topnotcher/gforce/master/ee/chest-xmega-rgb.pdf

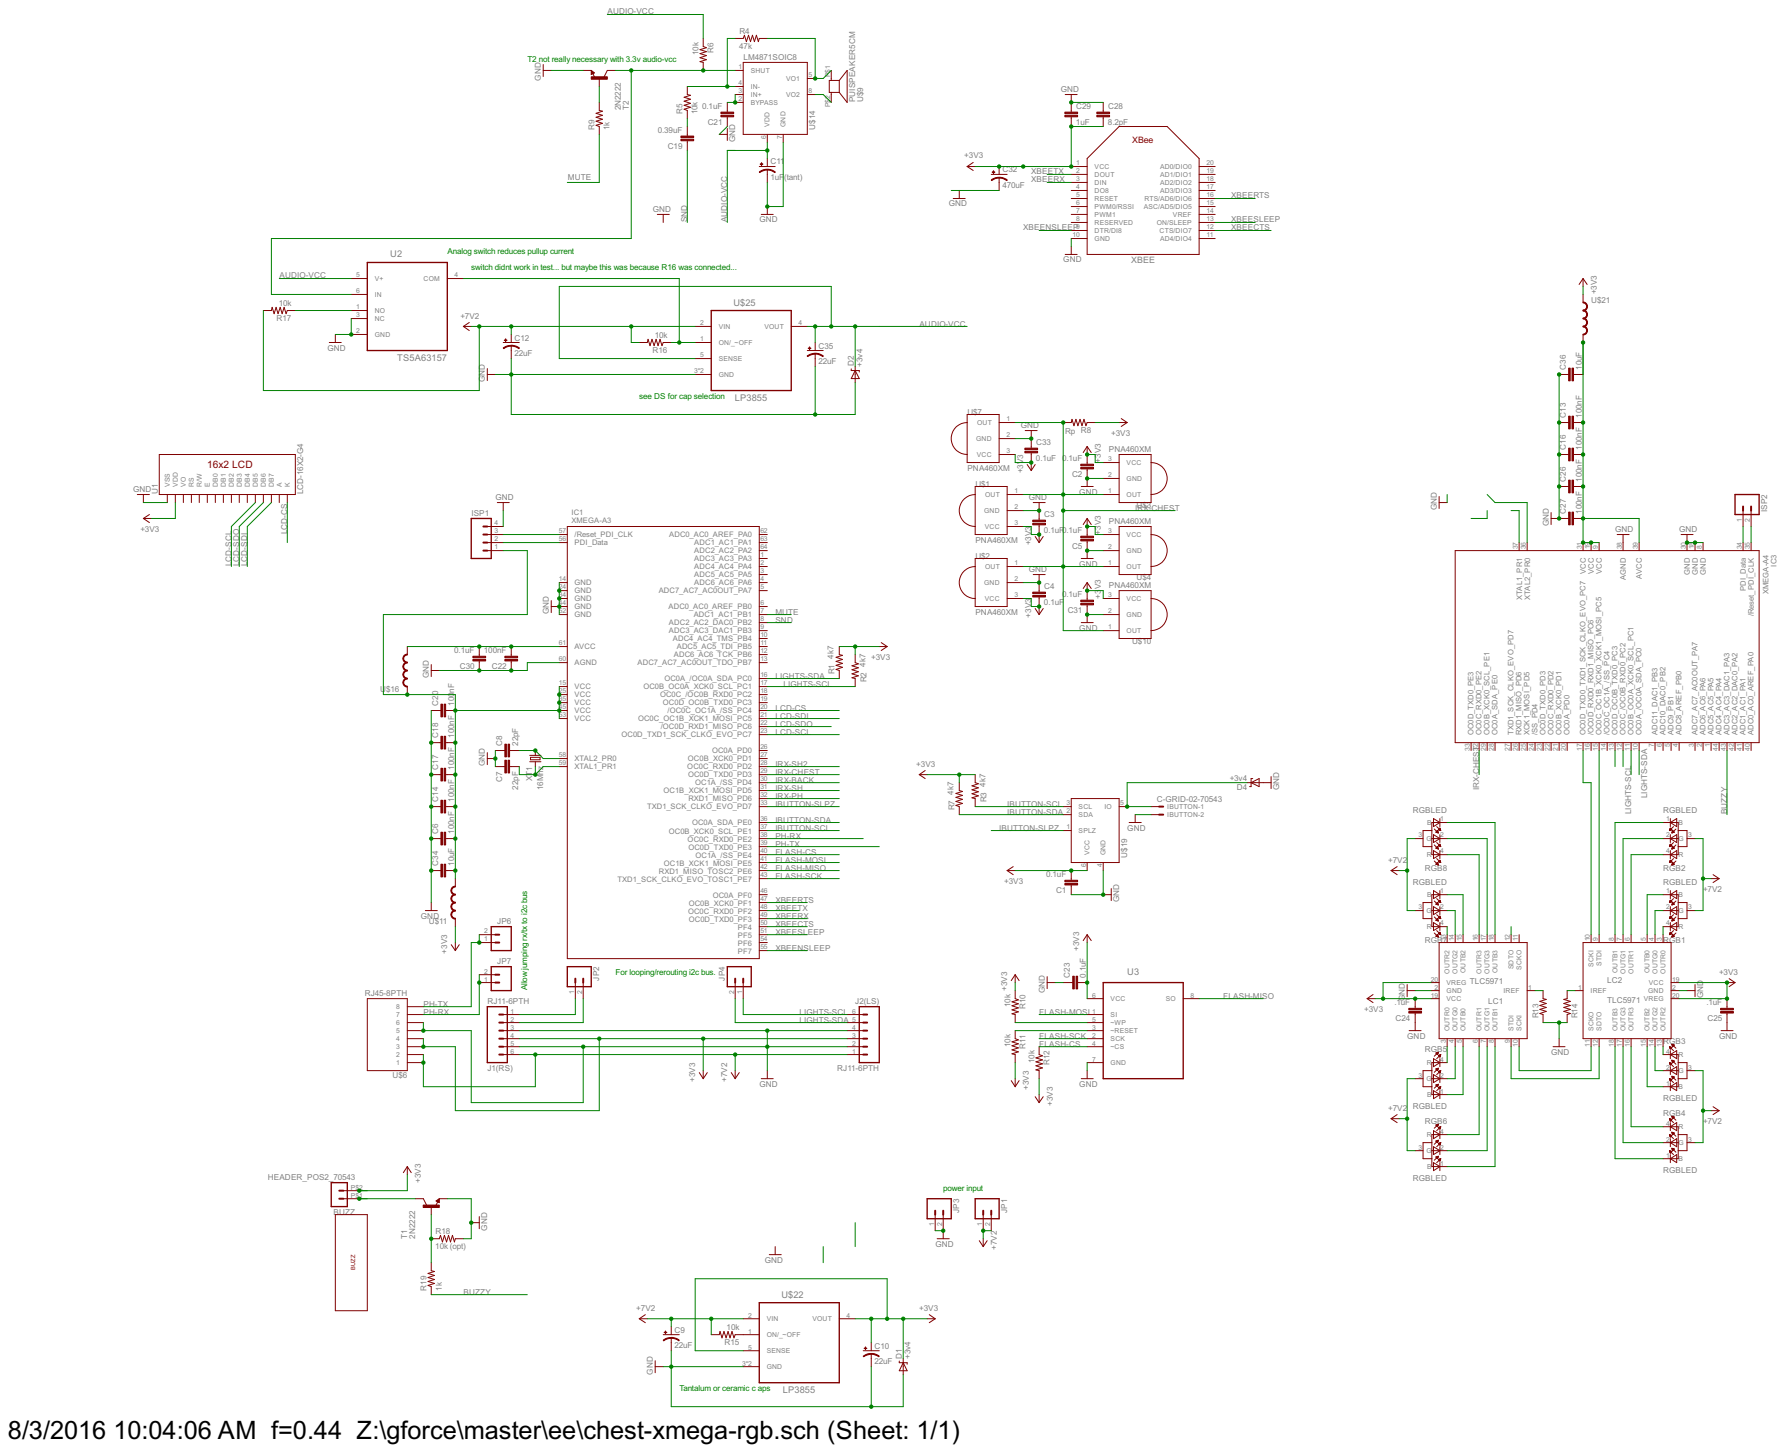
[picture p1: page 1]

T2 not really necessary with 3.3v audio-vcc

Analog switch reduces pullup current

switch didnt work in test... but maybe this was because R16 was connected...
+7V2 GND

see DS for cap selection

For looping/rerouting i2c bus. Allow jumping rx/tx to i2c bus

Tantalum or ceramic c aps

8/3/2016 10:04:06 AM f=0.44 Z:\gforce\master\ee\chest-xmega-rgb.sch (Sheet: 1/1)
