topnotcher/gforce/shoulder/ee/shoulder-board.pdf

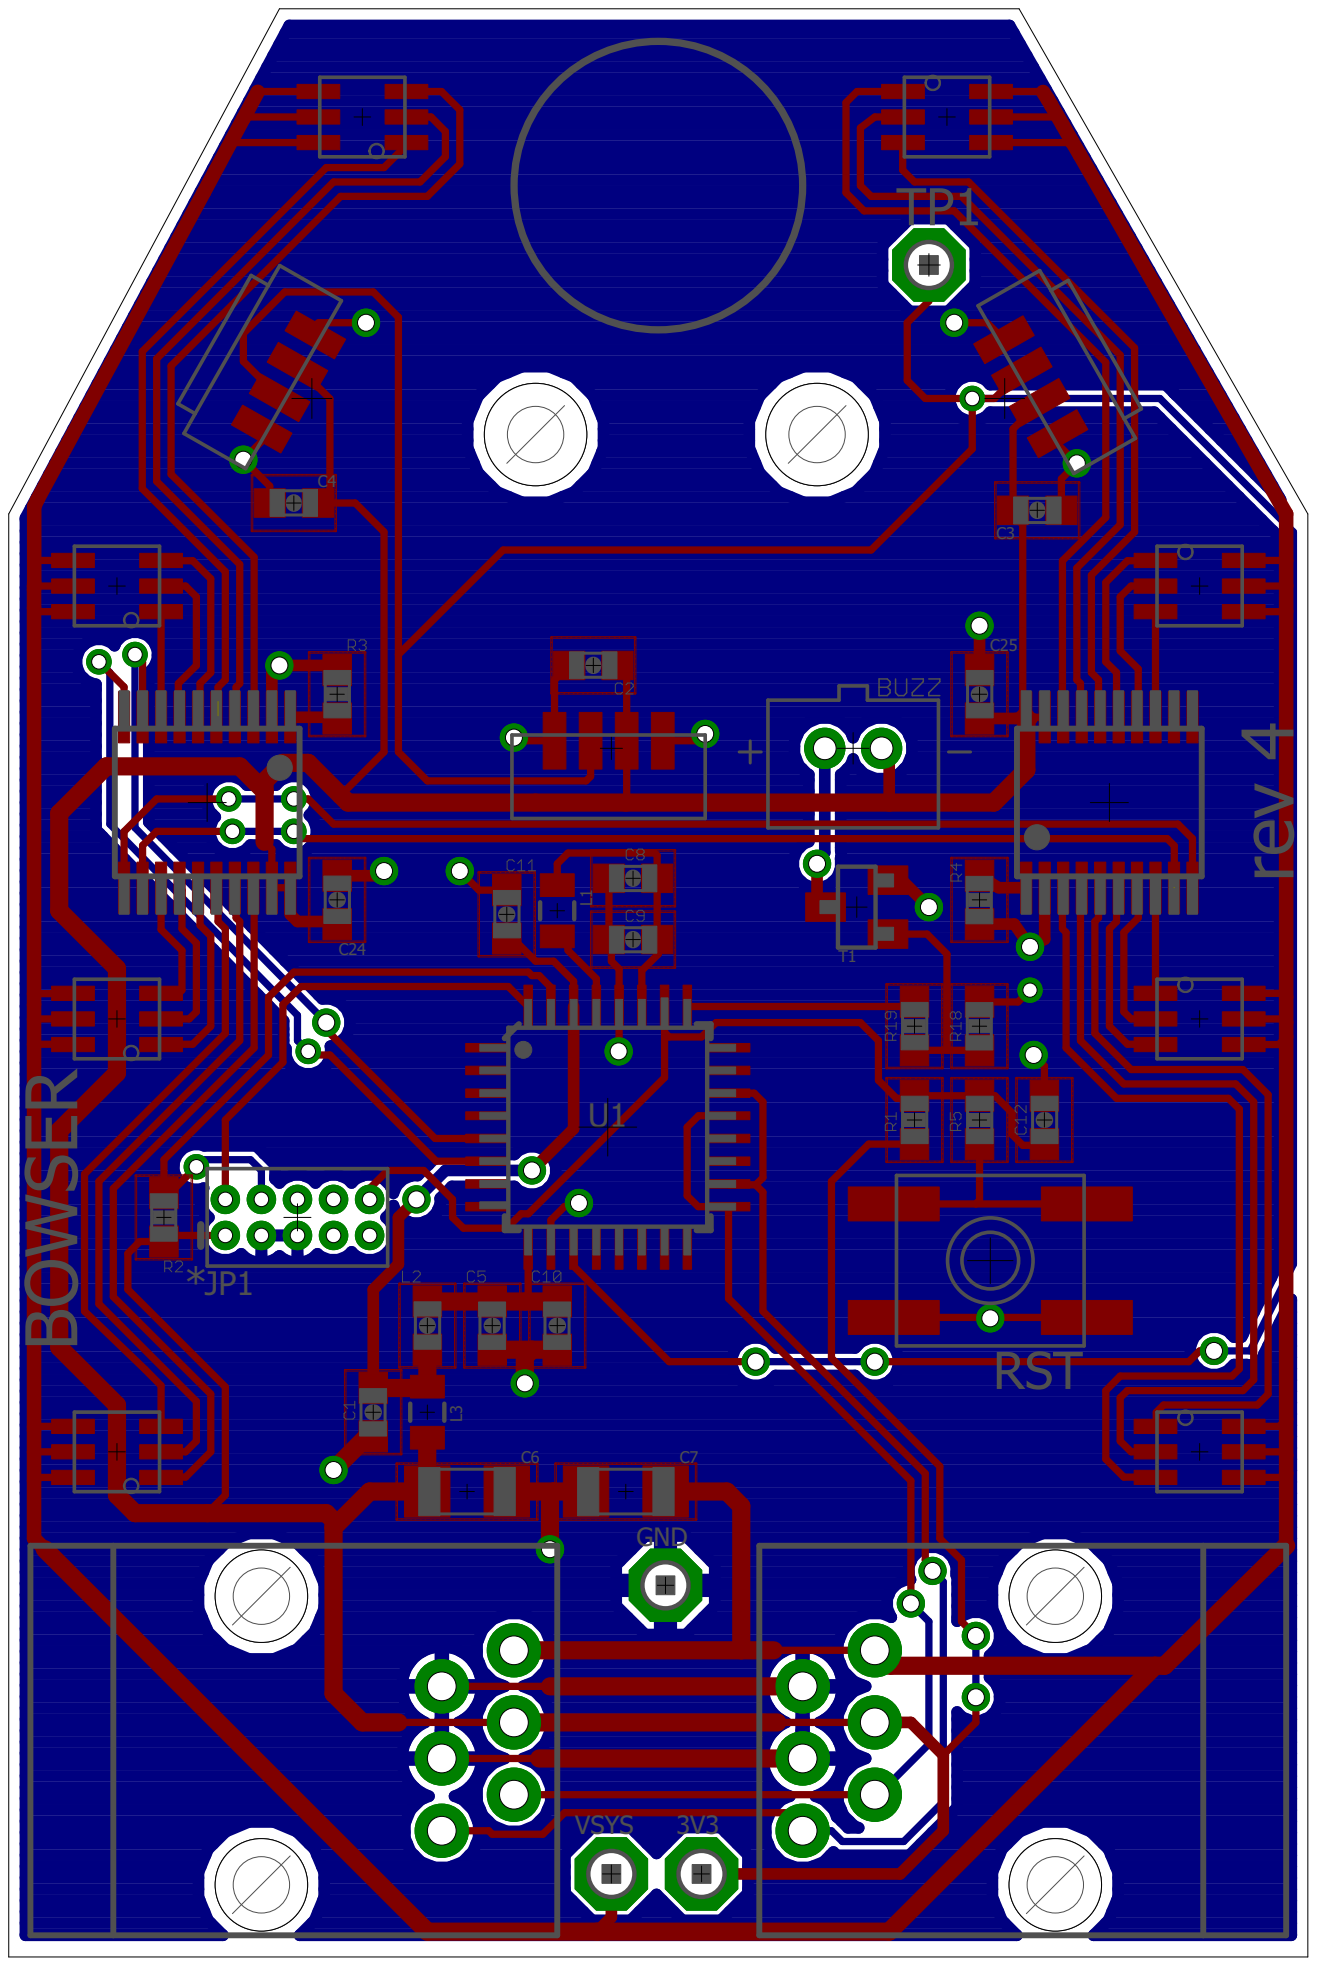
[picture p2: page 1]
