topnotcher/gforce/shoulder/ee/shoulder.pdf

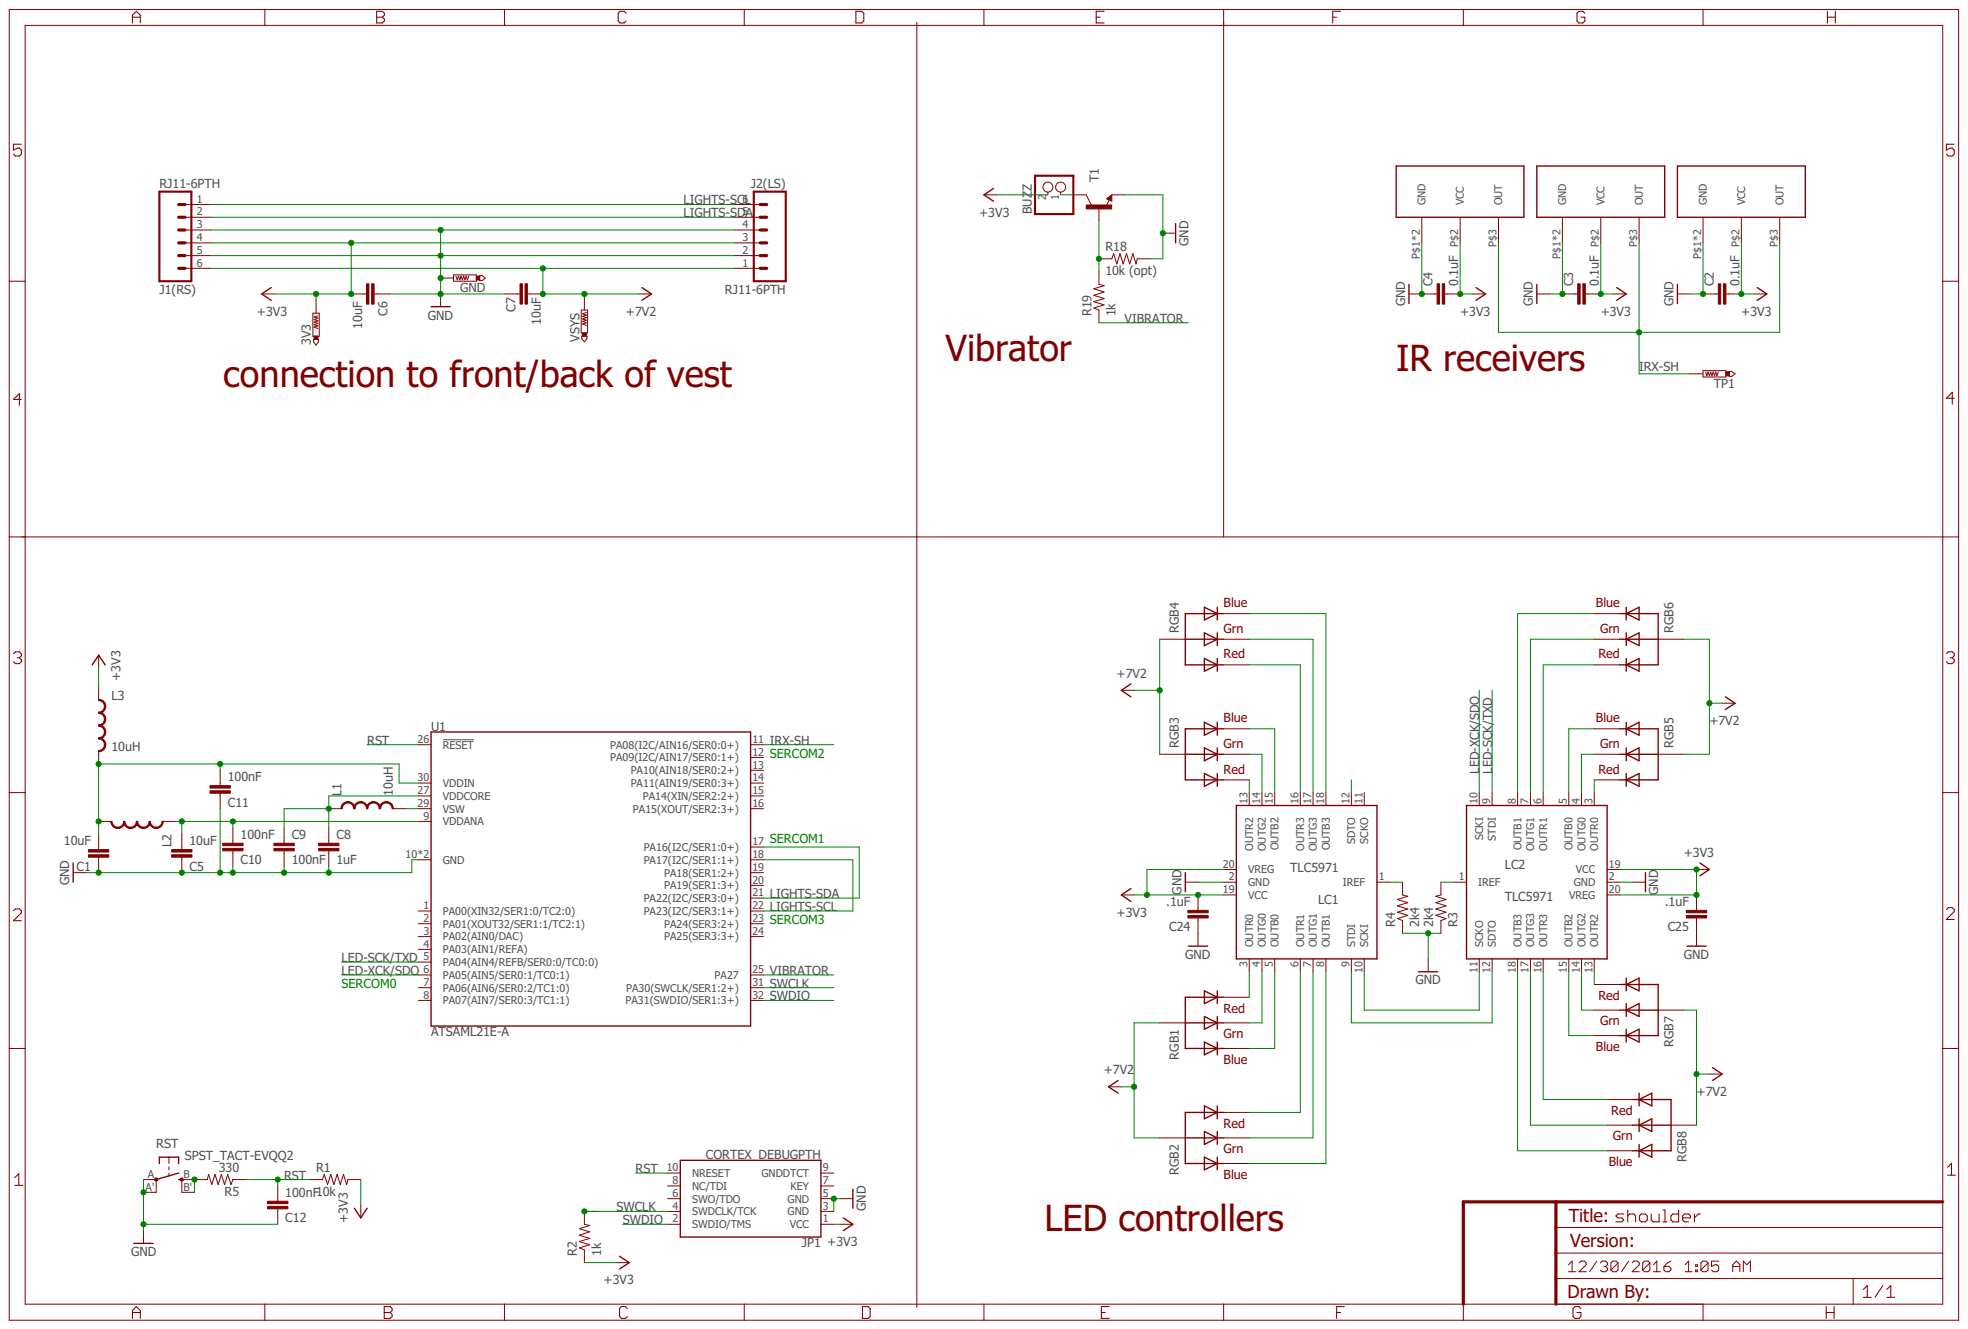
[picture p3: page 1]

Red Grn BlueRed Grn Blue
