topnotcher/gforce/phasor/ee/phasor-board.pdf

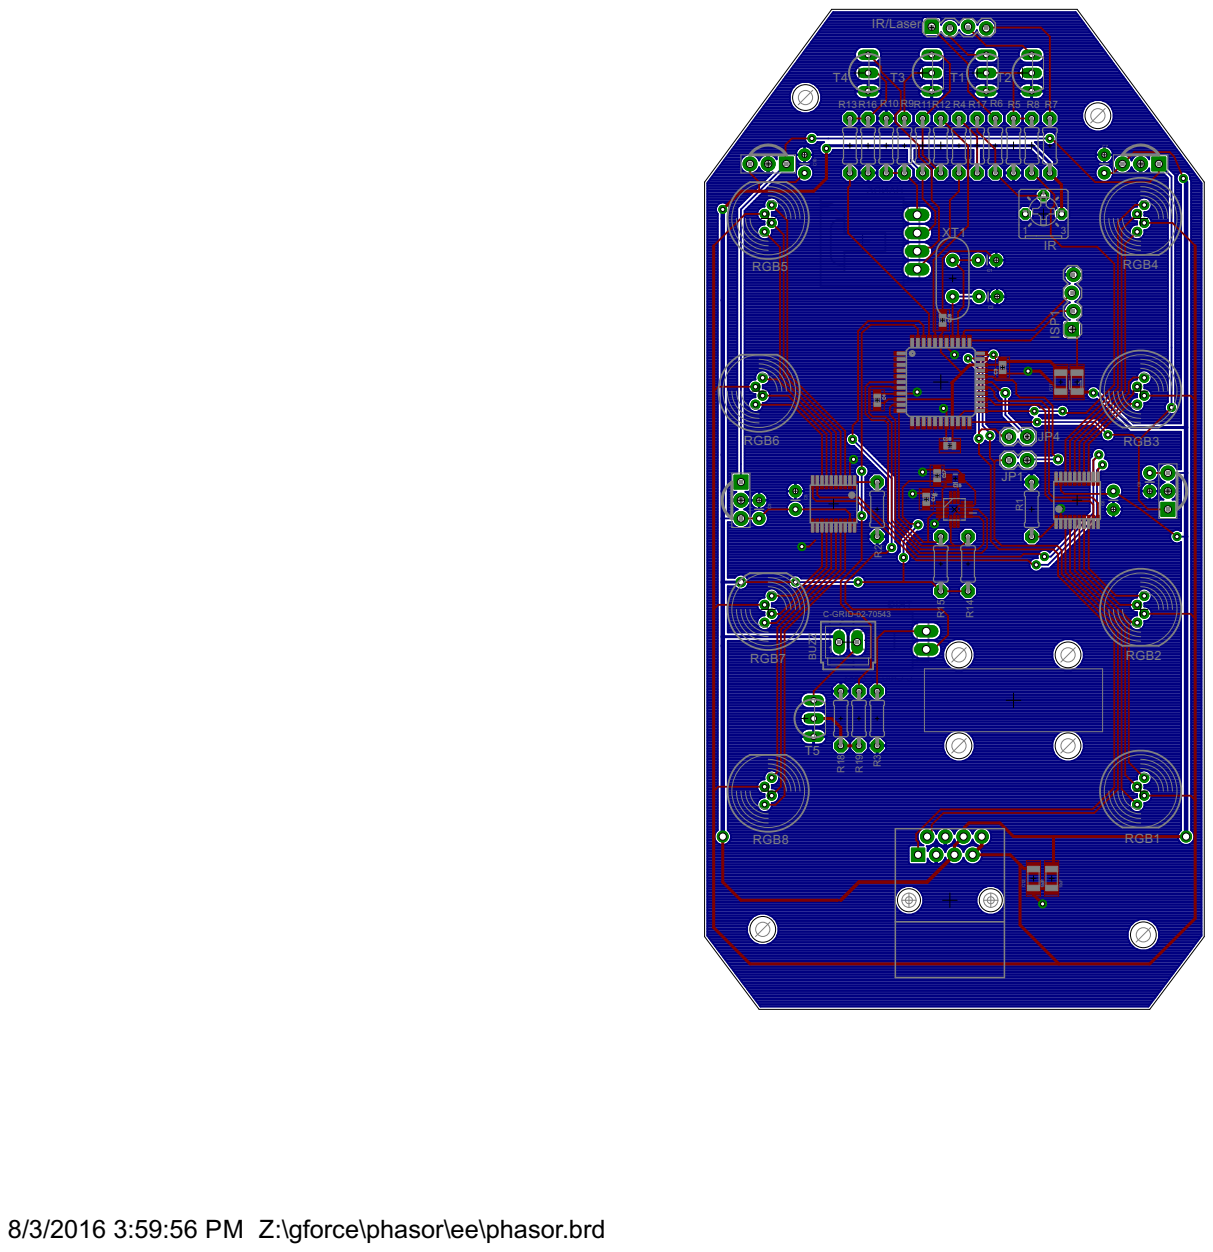
[picture p4: page 1]

8/3/2016 3:59:56 PM Z:\gforce\phasor\ee\phasor.brd
