topnotcher/gforce/phasor/ee/phasor.pdf

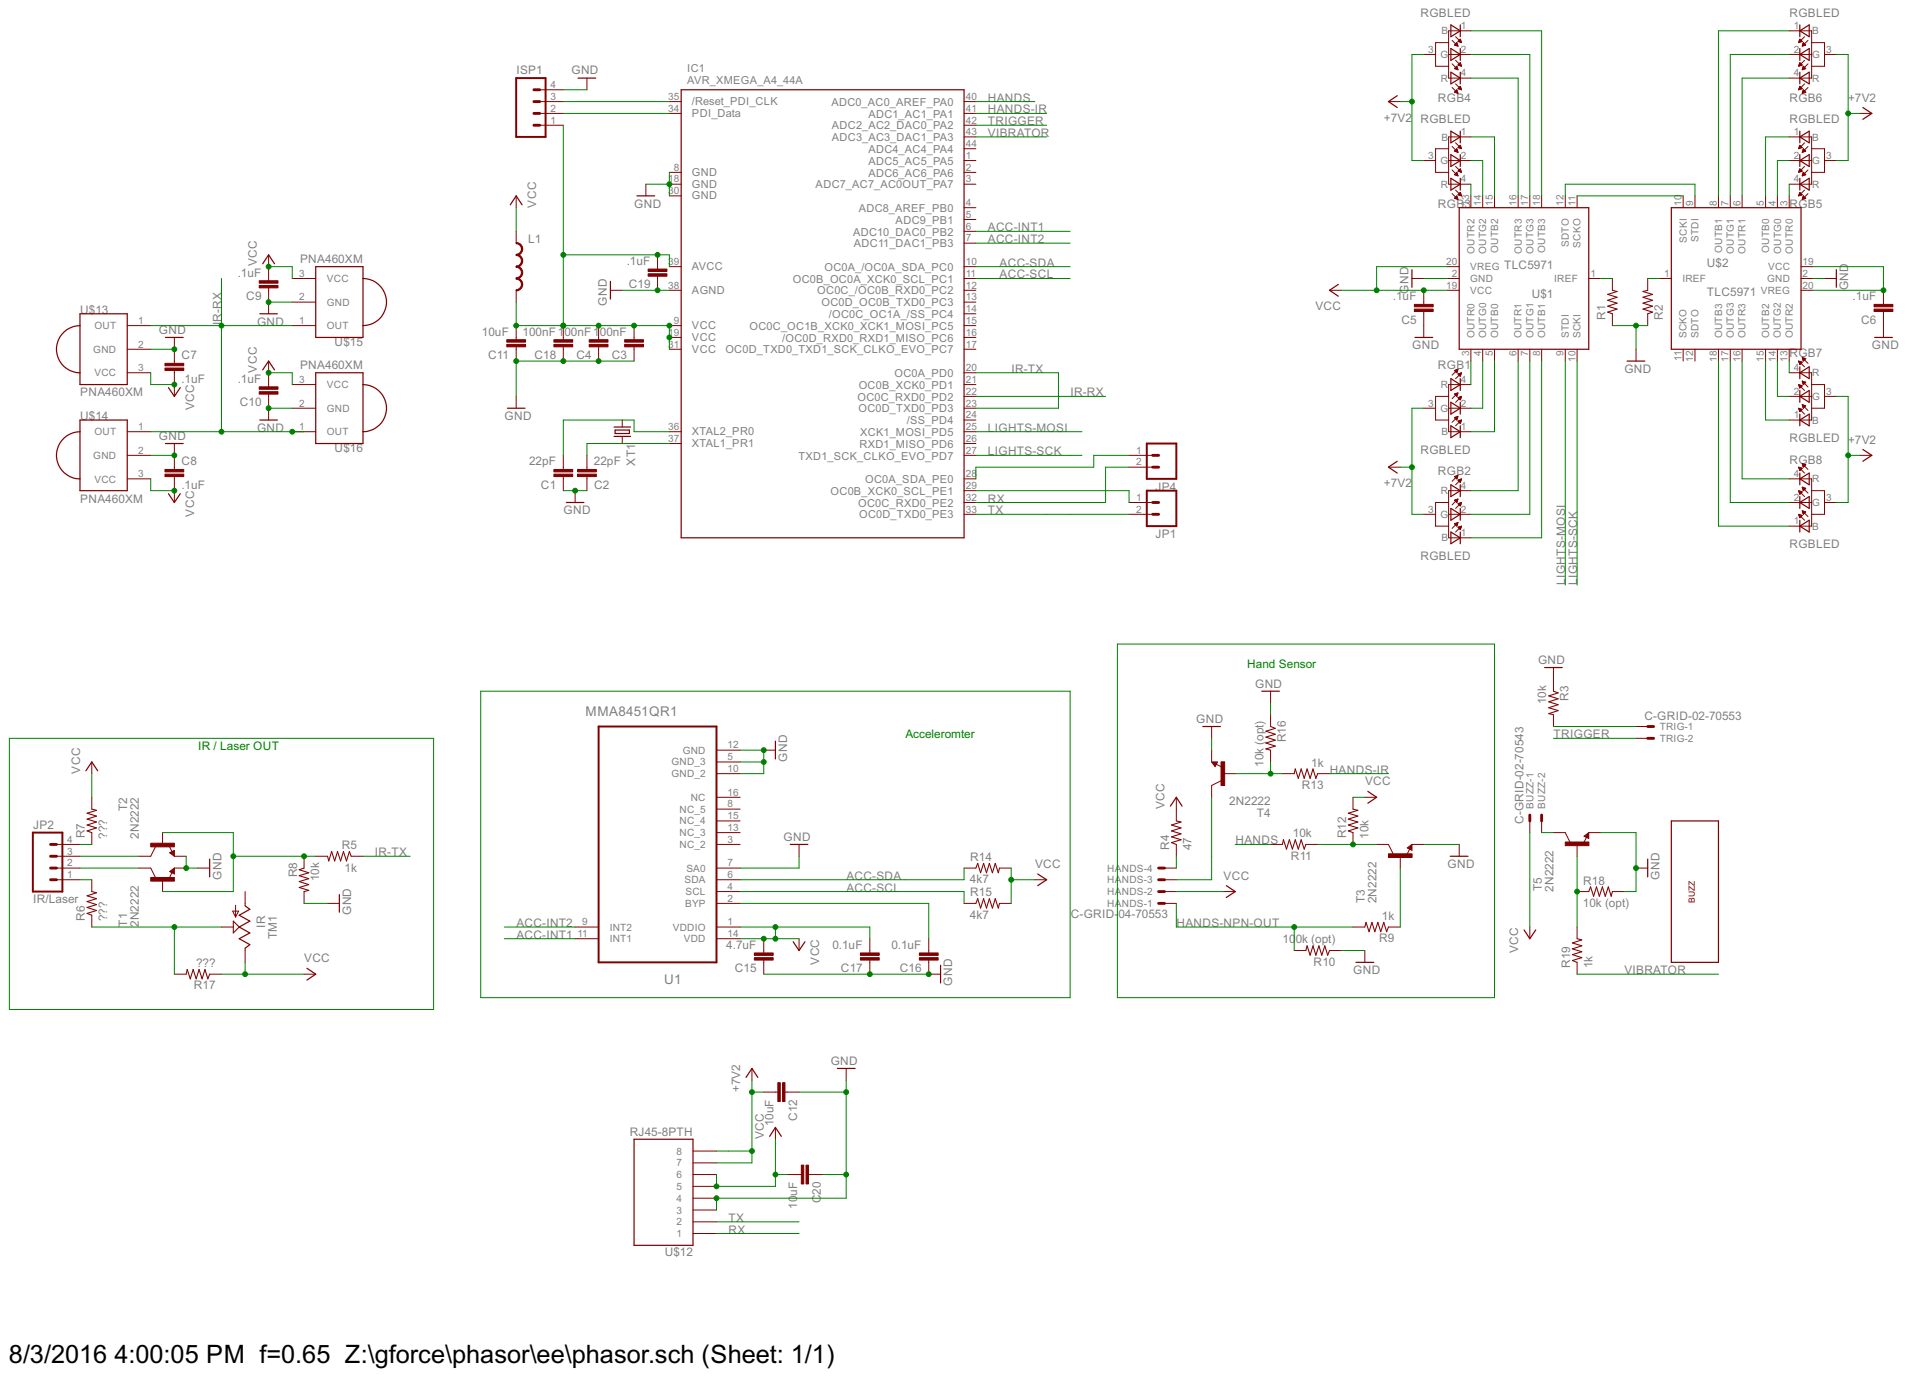
[picture p5: page 1]

HANDS-1 HANDS-2 HANDS-3 HANDS-4

HANDS-NPN-OUT ACC-INT1

8/3/2016 4:00:05 PM f=0.65 Z:\gforce\phasor\ee\phasor.sch (Sheet: 1/1)
