topnotcher/gforce/master/ee/chest-xmega-rgb-board.pdf

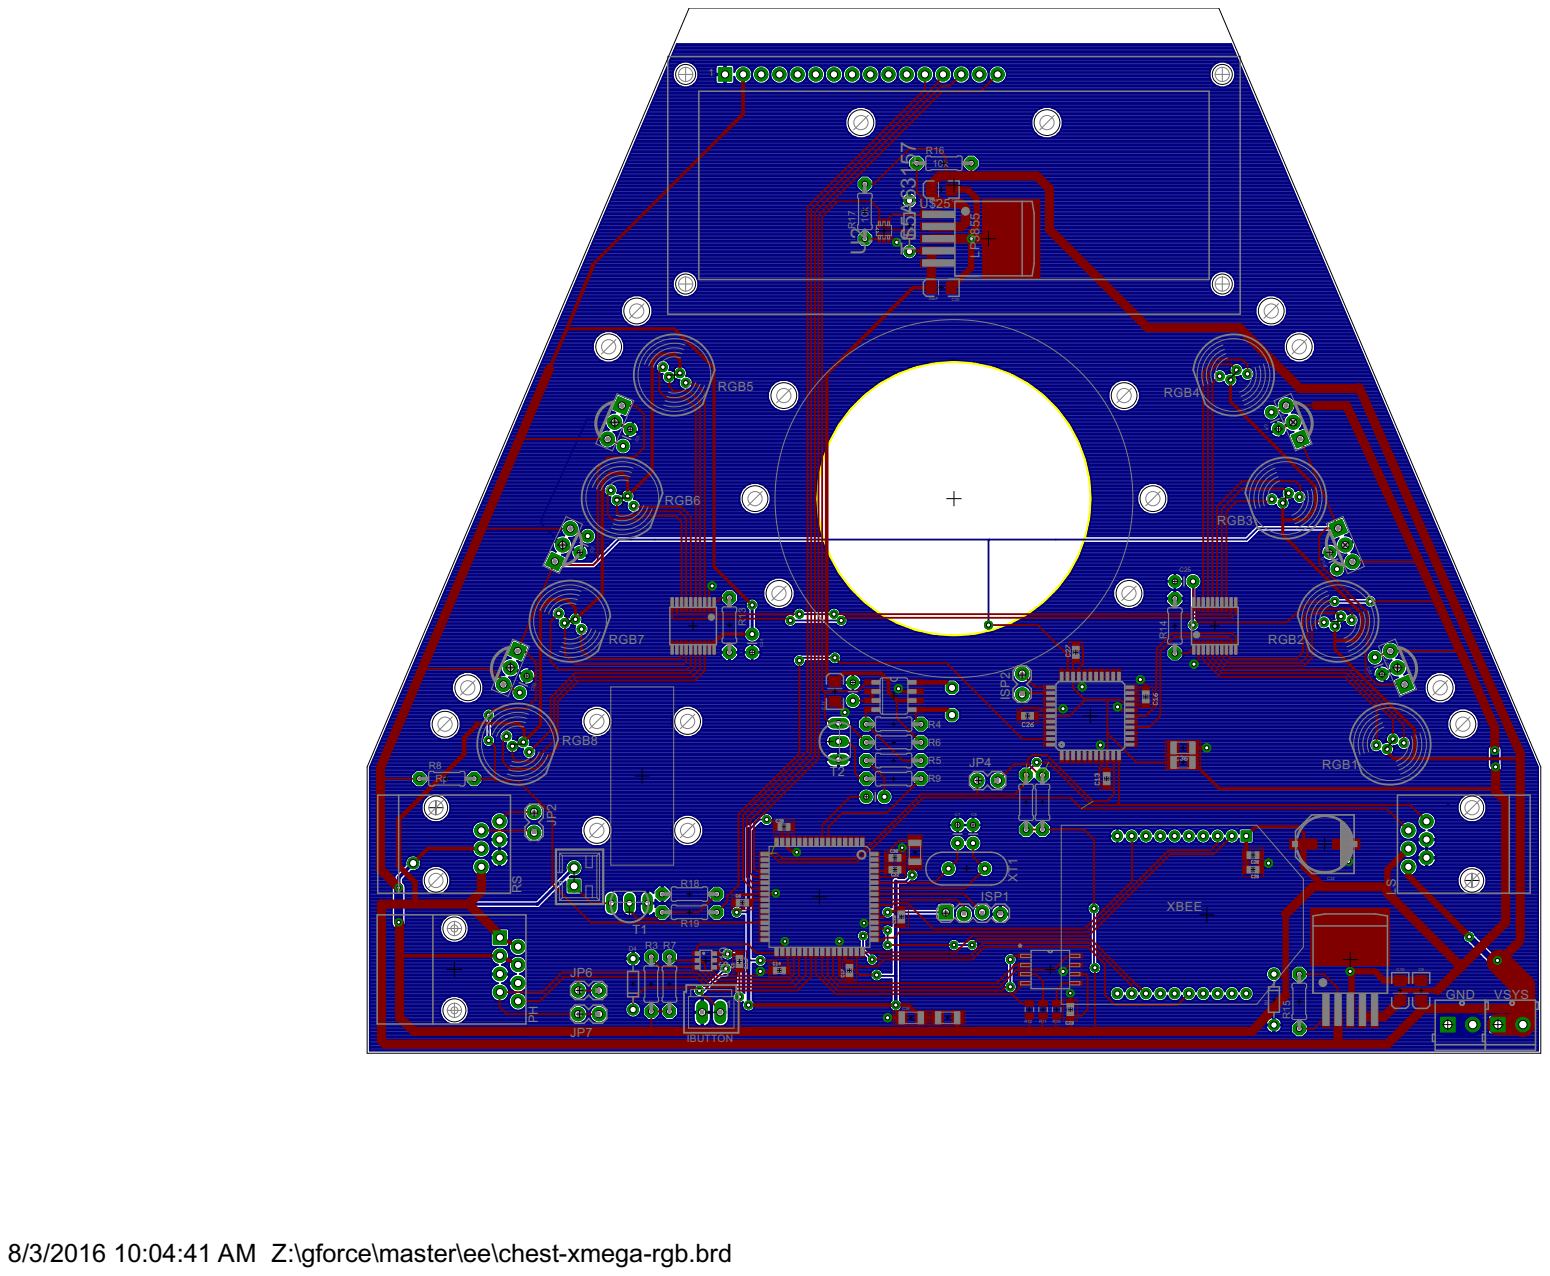
[picture p6: page 1]

8/3/2016 10:04:41 AM Z:\gforce\master\ee\chest-xmega-rgb.brd
