topnotcher/gforce/charger/ee/batt-charger.brd

## EAGLE design charger/ee/batt-charger.brd (2017-11-22)

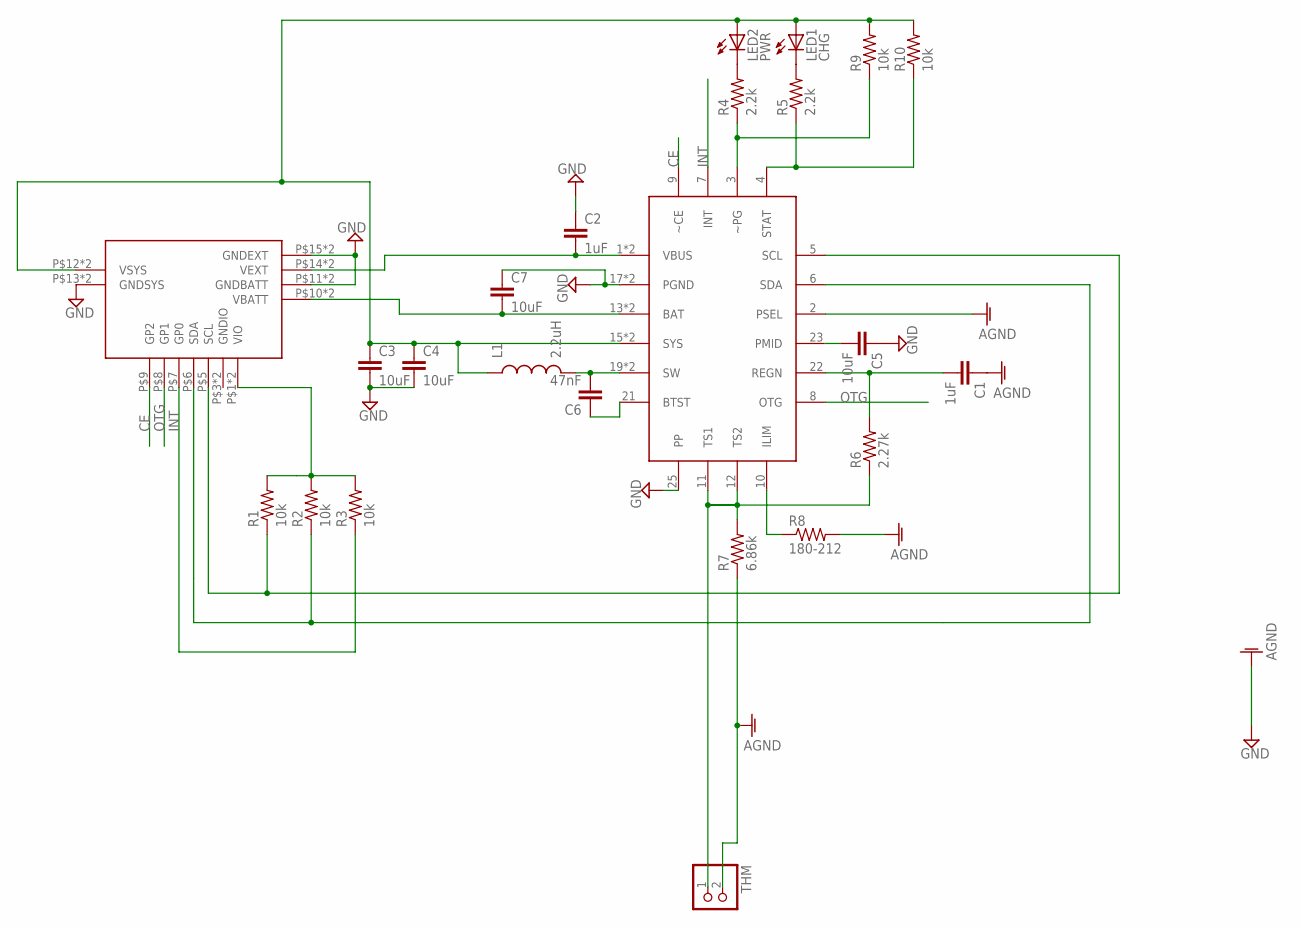
[picture p7: schematic batt-charger.sch]

Parts:
C1, C2: 1uF; 0603-CAP
C3, C4, C5, C7: 10uF; 1206
C6: 47nF; 0603-CAP
L1: 2.2uH; INDUCTOR-2020
LED1: CHG; CHIP-LED0603
LED2: PWR; CHIP-LED0603
R1, R2, R3, R9, R10: 10k; R0603
R4, R5: 2.2k; R0603
R6: 2.27k; R0603
R7: 6.86k; R0603
R8: 180-212; R0603
THM: JST_2PIN-THM; JST-PH-2-THM
U$1: BQ24193; QFN-400X400X100-25P
U$2: G4-CHG-SOCKETSTD; G4-CHG-SOCKET

Connections:
AGND: C1.1, R7.1, R8.2, THM.2 (1), U$1.2 (PSEL)
CE: U$1.9 (~CE), U$2.P$9 (GP2)
GND: C2.1, C3.2, C4.2, C5.1, C7.1, U$1.17 (PGND), U$1.18 (PGND), U$1.25 (PP), U$2.P$11 (GNDBATT), U$2.P$13 (GNDSYS), U$2.P$15 (GNDEXT), U$2.P$17 (GNDBATT), U$2.P$19 (GNDSYS), U$2.P$21 (GNDEXT)
INT: R3.1, U$1.7 (INT), U$2.P$7 (GP0)
unnamed: C6.2, L1.P$2 (2), U$1.19 (SW), U$1.20 (SW)
unnamed: R1.1, U$1.5 (SCL), U$2.P$5 (SCL)
unnamed: R2.1, U$1.6 (SDA), U$2.P$6 (SDA)
unnamed: C6.1, U$1.21 (BTST)
unnamed: LED2.C, R4.2
unnamed: LED1.C, R5.2
unnamed: R4.1, R9.1, U$1.3 (~PG)
unnamed: R5.1, R10.1, U$1.4 (STAT)
unnamed: C1.2, R6.2, U$1.22 (REGN)
unnamed: R6.1, R7.2, THM.1 (2), U$1.11 (TS1), U$1.12 (TS2)
unnamed: R8.1, U$1.10 (ILIM)
unnamed: C5.2, U$1.23 (PMID)
OTG: U$1.8 (OTG), U$2.P$8 (GP1)
VBATT: C7.2, U$1.13 (BAT), U$1.14 (BAT), U$2.P$10 (VBATT), U$2.P$16 (VBATT)
VEXT: C2.2, U$1.1 (VBUS), U$1.24 (VBUS), U$2.P$14 (VEXT), U$2.P$20 (VEXT)
VIO: R1.2, R2.2, R3.2, U$2.P$1 (VIO), U$2.P$2 (VIO)
VSYS: C3.1, C4.1, L1.P$1 (1), LED1.A, LED2.A, R9.2, R10.2, U$1.15 (SYS), U$1.16 (SYS), U$2.P$12 (VSYS), U$2.P$18 (VSYS)

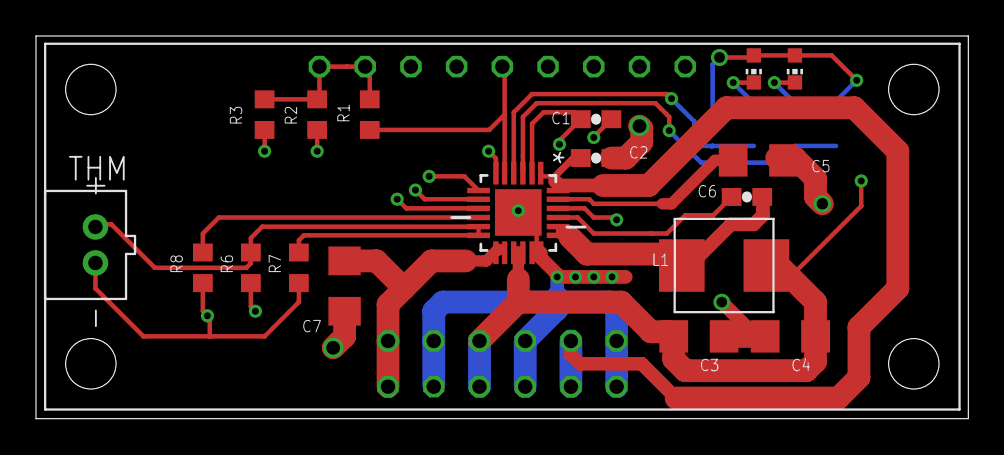
[picture p8: board batt-charger.brd from above]

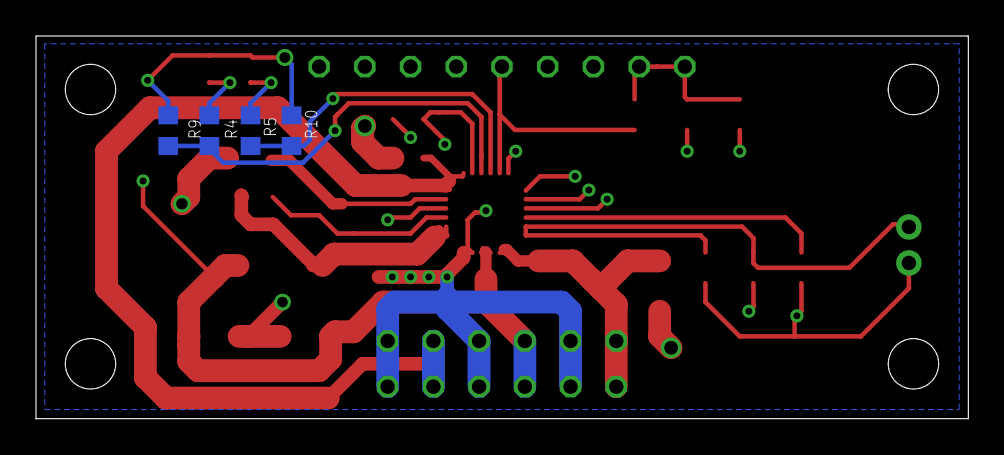
[picture p9: board batt-charger.brd from below]

Board: 4 copper layers, 51.8 x 21.3 mm, 23 parts (4 on the bottom side), 21 nets.
