topnotcher/gforce/shoulder/ee/shoulder.brd

## EAGLE design shoulder/ee/shoulder.brd (2017-01-27)

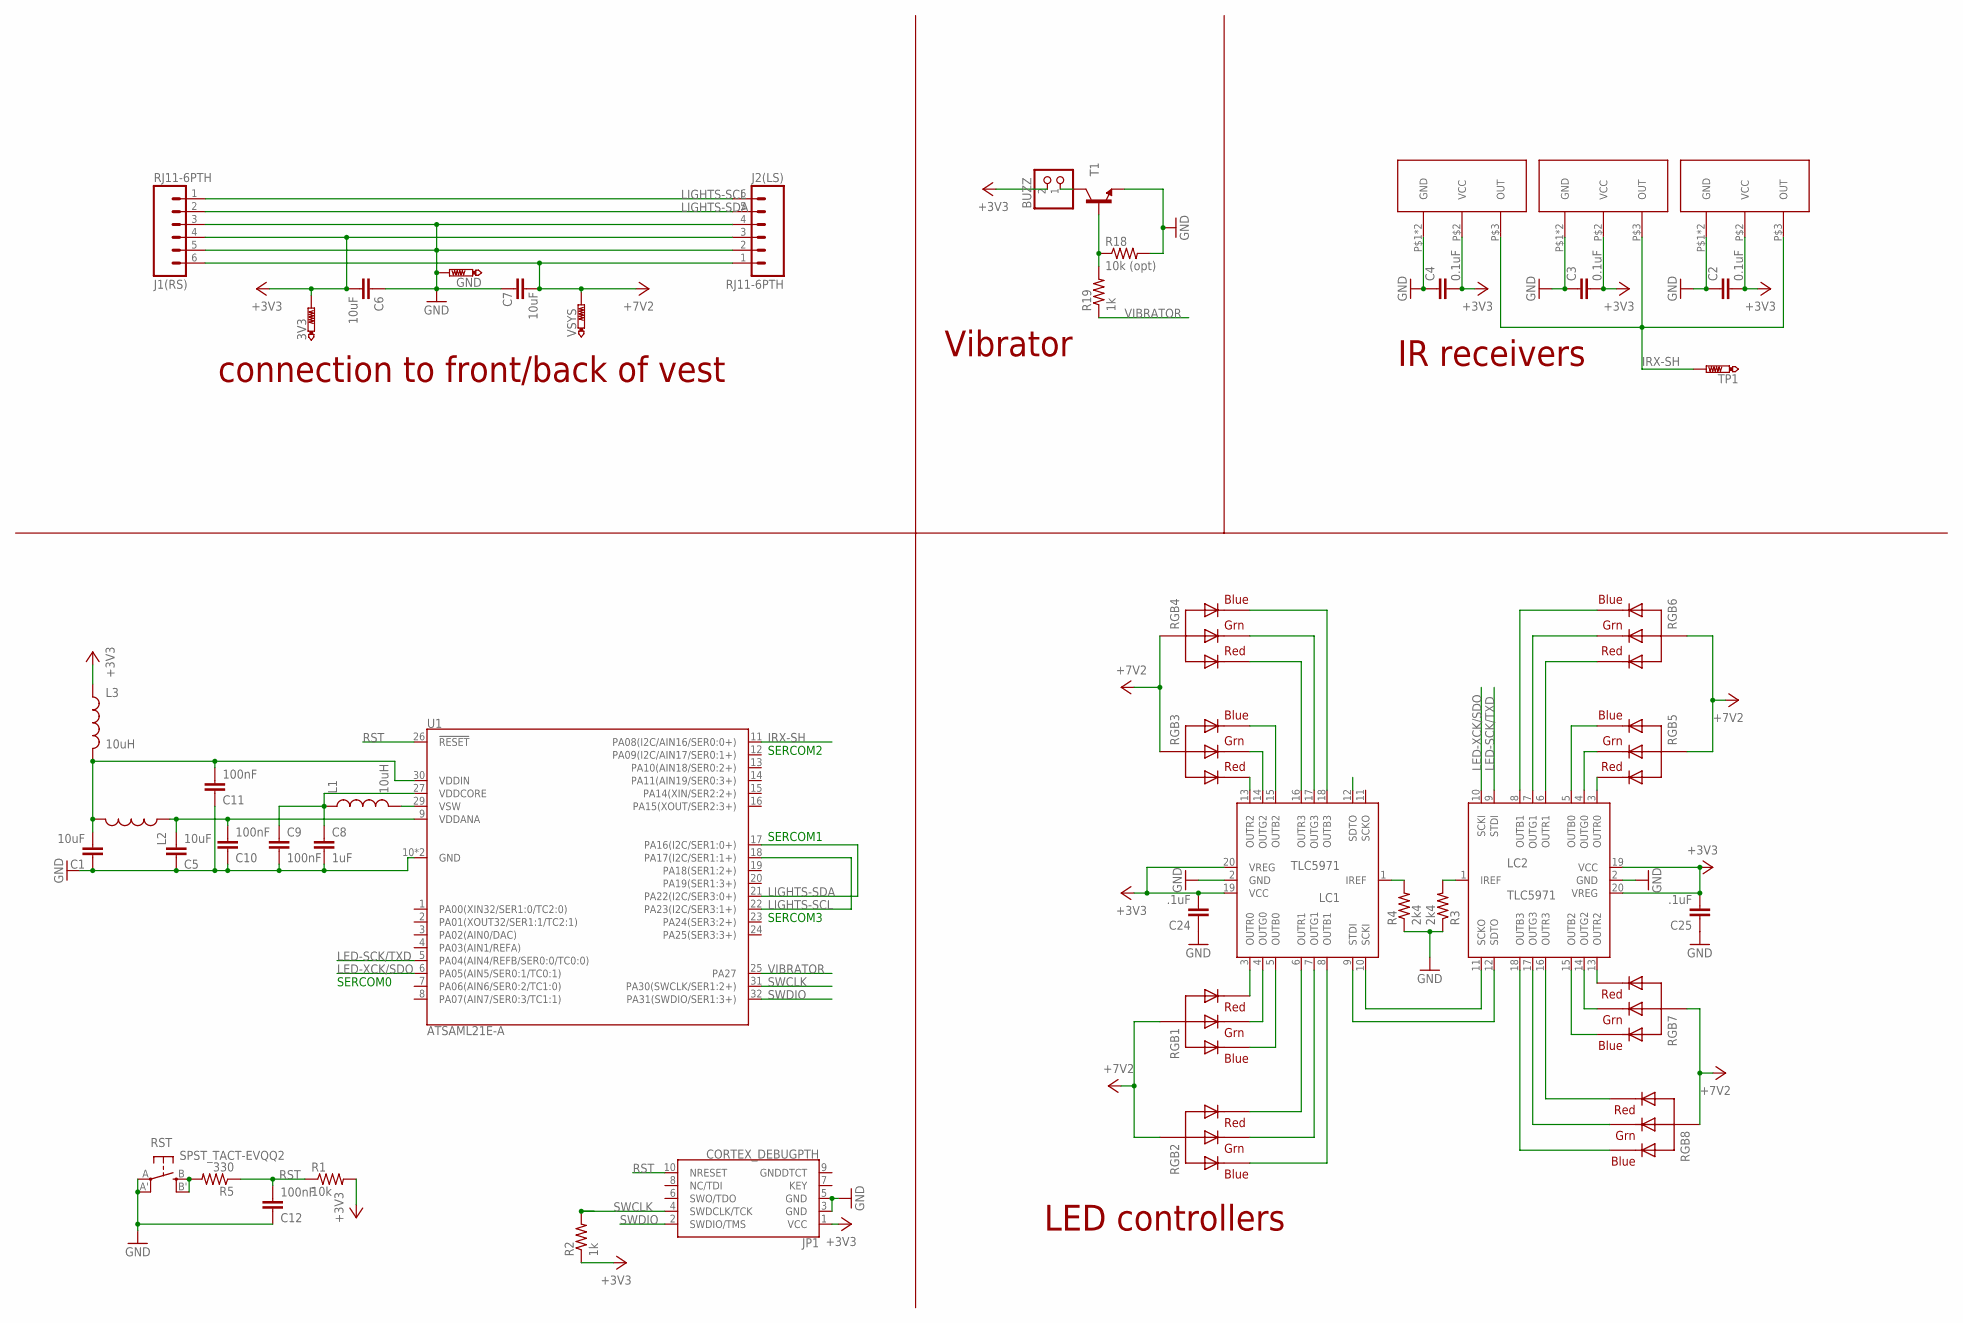
[picture p10: schematic shoulder.sch]

Parts:
3V3: PTR1PAD1-17; P1-17
BUZZ: JST_2PIN-THM; JST-PH-2-THM
C1, C5: 10uF; 0603-CAP
C2, C3, C4: 0.1uF; 0603-CAP
C6, C7: 10uF; 1206
C8: 1uF; 0603-CAP
C9, C10, C11, C12: 100nF; 0603-CAP
C24, C25: .1uF; 0603-CAP
GND: PTR1PAD1-17; P1-17
J1(RS), J2(LS): RJ11-6PTH; RJ11-6
JP1: CORTEX_DEBUGPTH; 2X5-PTH-1.27MM
L1, L3: 10uH; 0805
L2: INDUCTOR0603; 0603
LC1, LC2: TLC5971; SSOP20
R1: 10k; 0603-RES
R2, R19: 1k; 0603-RES
R3, R4: 2k4; 0603-RES
R5: 330; 0603-RES
R18: 10k (opt); 0603-RES
RGB1, RGB2, RGB3, RGB4, RGB5, RGB6, RGB7, RGB8: AVAGO-RGB-SMT; AVAGO-SMT-RGB
RST: SPST_TACT-EVQQ2; EVQ-Q2
T1: TRANSISTOR_NPNSOT23; SOT23
TP1: PTR1PAD1-17; P1-17
U1: ATSAML21E-A; TQFP-32-7X7-0.8MM
U$1, U$2: TSMP77000SIDE; TSMP77000
U$3: TSMP77000UP; HEIMDALL-UP
VSYS: PTR1PAD1-17; P1-17

Connections:
+3V3: 3V3.TP, BUZZ.2 (1), C2.2, C3.2, C4.2, C6.2, C24.2, C25.2, J1(RS).4, J2(LS).3, JP1.1 (VCC), L3.1, LC1.19 (VCC), LC1.20 (VREG), LC2.19 (VCC), LC2.20 (VREG), R1.2, R2.1, U$1.P$2 (VCC), U$2.P$2 (VCC), U$3.P$2 (VCC)
+7V2: C7.2, J1(RS).6, J2(LS).1, RGB1.P$4 (VCC), RGB1.P$5 (VCC), RGB1.P$6 (VCC), RGB2.P$4 (VCC), RGB2.P$5 (VCC), RGB2.P$6 (VCC), RGB3.P$4 (VCC), RGB3.P$5 (VCC), RGB3.P$6 (VCC), RGB4.P$4 (VCC), RGB4.P$5 (VCC), RGB4.P$6 (VCC), RGB5.P$4 (VCC), RGB5.P$5 (VCC), RGB5.P$6 (VCC), RGB6.P$4 (VCC), RGB6.P$5 (VCC), RGB6.P$6 (VCC), RGB7.P$4 (VCC), RGB7.P$5 (VCC), RGB7.P$6 (VCC), RGB8.P$4 (VCC), RGB8.P$5 (VCC), RGB8.P$6 (VCC), VSYS.TP
GND: C1.1, C2.1, C3.1, C4.1, C5.1, C6.1, C7.1, C8.2, C9.2, C10.1, C11.1, C12.1, C24.1, C25.1, GND.TP, J1(RS).3, J1(RS).5, J2(LS).2, J2(LS).4, JP1.3 (GND), JP1.5 (GND), LC1.2 (GND), LC2.2 (GND), R3.1, R4.1, R18.2, RST.A, RST.A' (P1), T1.2 (E), U1.10 (GND), U1.28 (GND), U$1.P$1 (GND), U$1.P$4 (GND), U$2.P$1 (GND), U$2.P$4 (GND), U$3.P$1 (GND), U$3.P$4 (GND)
IRX-SH: TP1.TP, U1.11 (PA08(I2C/AIN16/SER0:0+)), U$1.P$3 (OUT), U$2.P$3 (OUT), U$3.P$3 (OUT)
LED-SCK/TXD: LC2.9 (STDI), U1.5 (PA04(AIN4/REFB/SER0:0/TC0:0))
LED-XCK/SDO: LC2.10 (SCKI), U1.6 (PA05(AIN5/SER0:1/TC0:1))
LIGHTS-SCL: J1(RS).1, J2(LS).6, U1.18 (PA17(I2C/SER1:1+)), U1.22 (PA23(I2C/SER3:1+))
LIGHTS-SDA: J1(RS).2, J2(LS).5, U1.17 (PA16(I2C/SER1:0+)), U1.21 (PA22(I2C/SER3:0+))
unnamed: LC1.10 (SCKI), LC2.11 (SCKO)
unnamed: LC1.9 (STDI), LC2.12 (SDTO)
unnamed: C5.2, C10.2, L2.1, U1.9 (VDDANA)
unnamed: C1.2, C11.2, L2.2, L3.2, U1.30 (VDDIN)
unnamed: R5.2, RST.B (S), RST.B' (S1)
unnamed: L1.2, U1.29 (VSW)
unnamed: LC1.3 (OUTR0), RGB1.P$3 (RED)
unnamed: LC2.3 (OUTR0), RGB5.P$3 (RED)
unnamed: LC2.6 (OUTR1), RGB6.P$3 (RED)
unnamed: C8.1, C9.1, L1.1, U1.27 (VDDCORE)
unnamed: BUZZ.1 (2), T1.3 (C)
unnamed: LC1.15 (OUTB2), RGB3.P$1 (BLUE)
unnamed: R18.1, R19.2, T1.1 (B)
unnamed: LC1.13 (OUTR2), RGB3.P$3 (RED)
unnamed: LC1.14 (OUTG2), RGB3.P$2 (GREEN)
unnamed: LC1.16 (OUTR3), RGB4.P$3 (RED)
unnamed: LC1.17 (OUTG3), RGB4.P$2 (GREEN)
unnamed: LC1.18 (OUTB3), RGB4.P$1 (BLUE)
unnamed: LC1.4 (OUTG0), RGB1.P$2 (GREEN)
unnamed: LC1.5 (OUTB0), RGB1.P$1 (BLUE)
unnamed: LC1.6 (OUTR1), RGB2.P$3 (RED)
unnamed: LC1.7 (OUTG1), RGB2.P$2 (GREEN)
unnamed: LC1.8 (OUTB1), RGB2.P$1 (BLUE)
unnamed: LC2.4 (OUTG0), RGB5.P$2 (GREEN)
unnamed: LC2.5 (OUTB0), RGB5.P$1 (BLUE)
unnamed: LC2.7 (OUTG1), RGB6.P$2 (GREEN)
unnamed: LC2.8 (OUTB1), RGB6.P$1 (BLUE)
unnamed: LC2.16 (OUTR3), RGB8.P$3 (RED)
unnamed: LC2.17 (OUTG3), RGB8.P$2 (GREEN)
unnamed: LC2.18 (OUTB3), RGB8.P$1 (BLUE)
unnamed: LC2.15 (OUTB2), RGB7.P$1 (BLUE)
unnamed: LC2.14 (OUTG2), RGB7.P$2 (GREEN)
unnamed: LC2.13 (OUTR2), RGB7.P$3 (RED)
unnamed: LC1.1 (IREF), R4.2
unnamed: LC2.1 (IREF), R3.2
RST: C12.2, JP1.10 (NRESET), R1.1, R5.1, U1.26 (!RESET!)
SWCLK: JP1.4 (SWDCLK/TCK), R2.2, U1.31 (PA30(SWCLK/SER1:2+))
SWDIO: JP1.2 (SWDIO/TMS), U1.32 (PA31(SWDIO/SER1:3+))
VIBRATOR: R19.1, U1.25 (PA27)

Notes on the sheet:
connection to front/back of vest
IR receivers
Vibrator
LED controllers
SERCOM0
SERCOM3
SERCOM1
SERCOM2

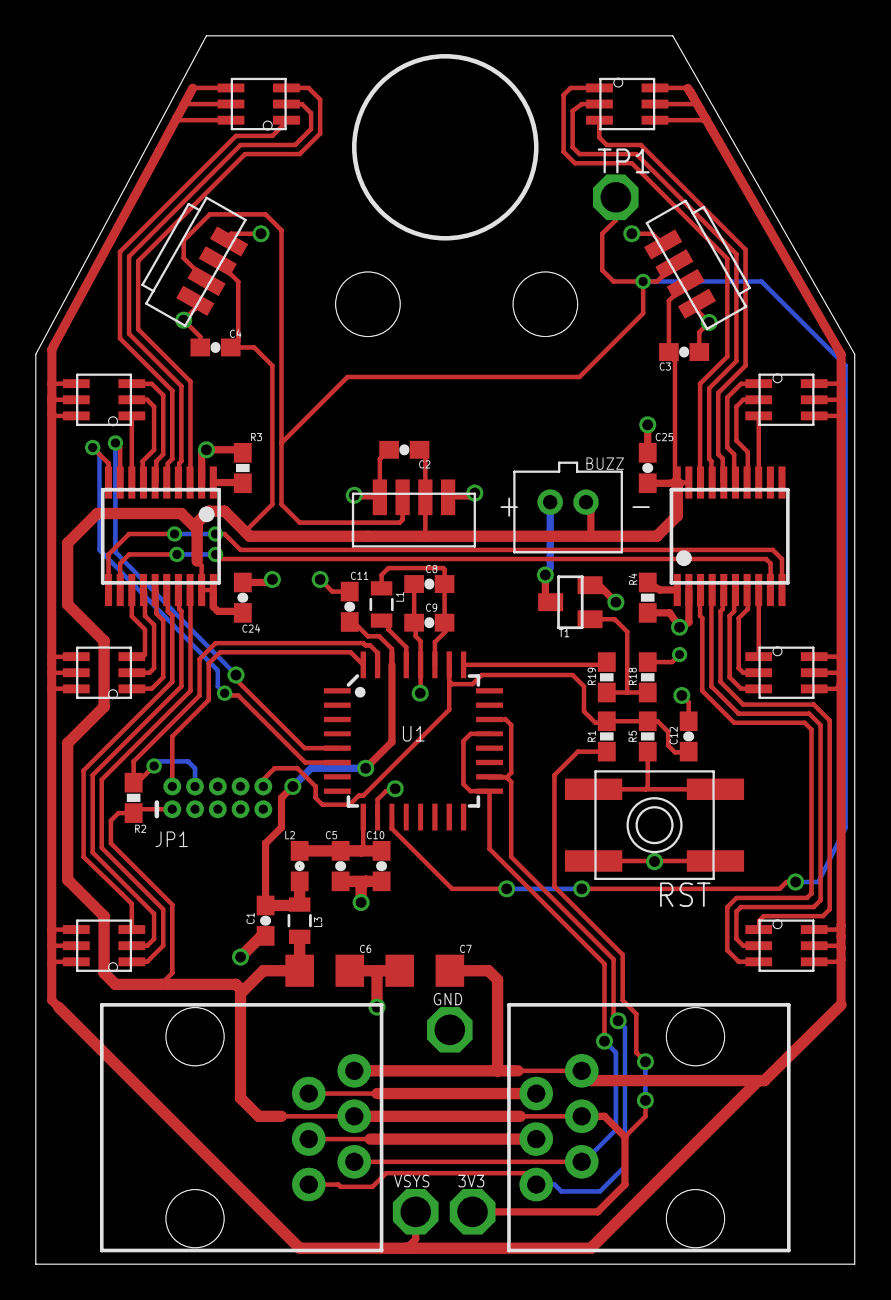
[picture p11: board shoulder.brd from above]

Board: 2 copper layers, 45.7 x 68.6 mm, 48 parts (0 on the bottom side), 47 nets.
