topnotcher/gforce/phasor/ee/phasor.brd

## EAGLE design phasor/ee/phasor.brd (2016-08-03)

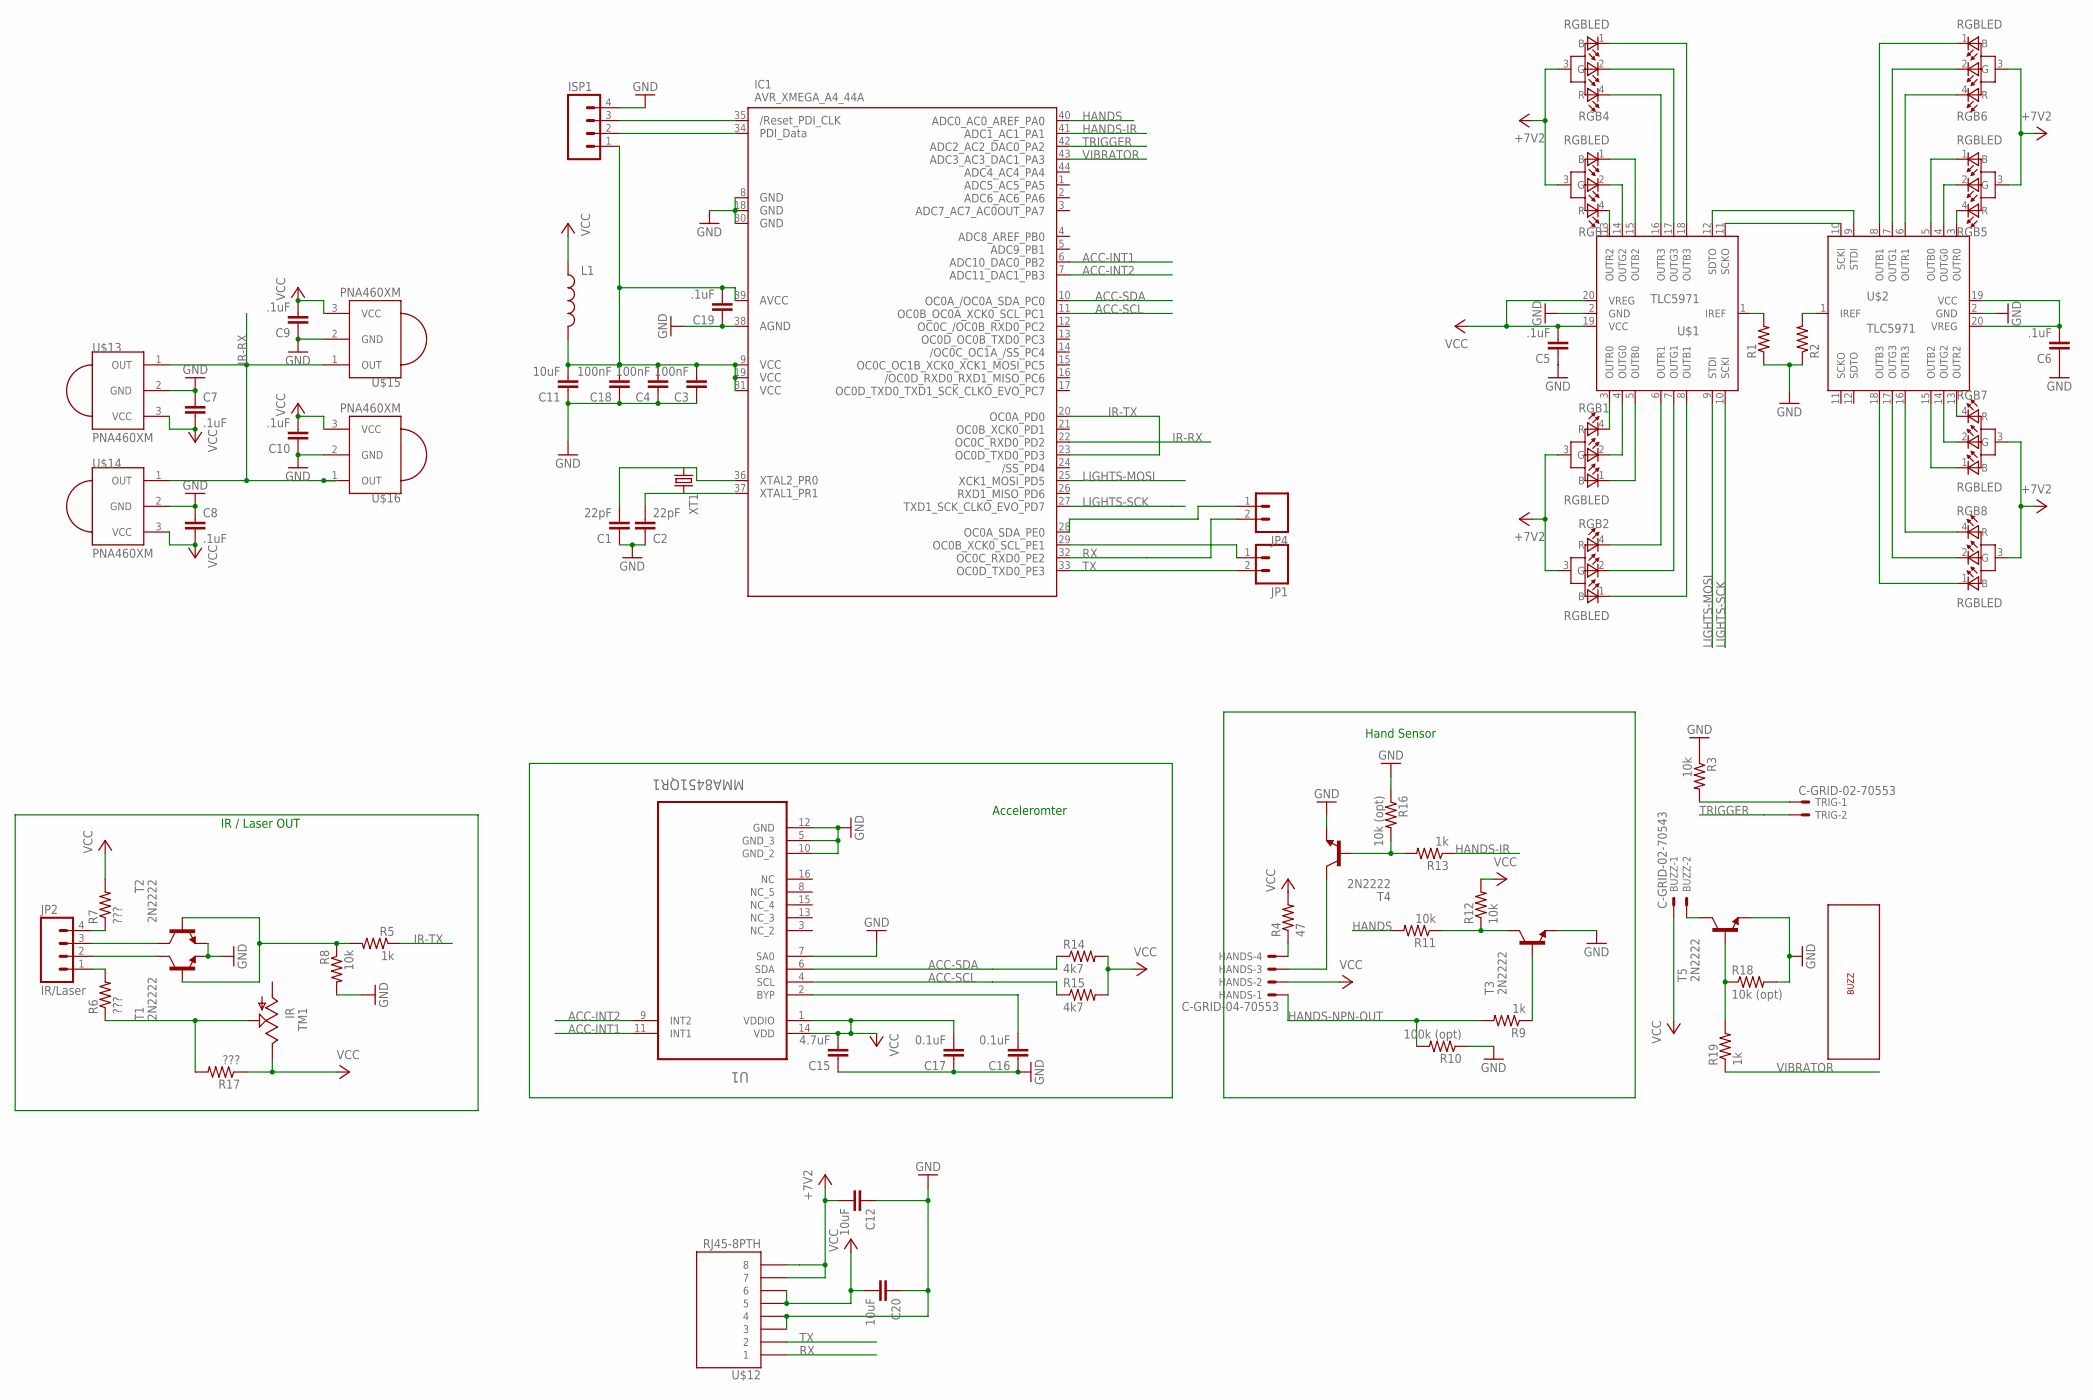
[picture p12: schematic phasor.sch]

Parts:
BUZZ: C-GRID-02-70543; 70543-02
C1, C2: 22pF; CAP-PTH-SMALL
C3, C4, C18: 100nF; 0603-CAP
C5, C6, C7, C8, C9, C10: .1uF; CAP-PTH-SMALL
C11, C12, C20: 10uF; 1206
C15: 4.7uF; 0805
C16, C17: 0.1uF; 0603-CAP
C19: .1uF; 0603-CAP
HANDS: C-GRID-04-70553; 70553-04
IC1: AVR_XMEGA_A4_44A; TQFP44
ISP1: M04LOCK; 1X04_LOCK
JP1, JP4: M02PTH; 1X02
JP2: IR/Laser; 1X04_LOCK
L1: INDUCTOR1206H*; 1206
R1, R2: R-US_0204/7; 0204/7
R3, R8, R11, R12: 10k; 0204/7
R4: 47; 0204/7
R5, R9, R13, R19: 1k; 0204/7
R6, R7, R17: ???; 0204/7
R10: 100k (opt); 0204/7
R14, R15: 4k7; 0204/7
R16, R18: 10k (opt); 0204/7
RGB1, RGB2, RGB3, RGB4, RGB5, RGB6, RGB7, RGB8: RGBLED; RGB-LED-10MM-COMMON-ANODE
T1, T2, T3, T4, T5: 2N2222; TO92-EBC-OVAL
TM1: IR; B25P
TRIG: C-GRID-02-70553; 70553-02
U1: MMA8451QR1; QFN50P300X300X100-16N
U$1, U$2: TLC5971; SSOP20
U$3: VIB-CAPSULE
U$12: RJ45-8PTH; RJ45-8
U$13, U$14, U$15, U$16: PNA460XM
XT1: CRYSTALHC49US; HC49US

Connections:
+7V2: C12.2, RGB1.3 (VCC), RGB2.3 (VCC), RGB3.3 (VCC), RGB4.3 (VCC), RGB5.3 (VCC), RGB6.3 (VCC), RGB7.3 (VCC), RGB8.3 (VCC), U$12.7, U$12.8
ACC-INT1: IC1.6 (PB2), U1.11 (INT1)
ACC-INT2: IC1.7 (PB3), U1.9 (INT2)
ACC-SCL: IC1.11 (PC1), R15.1, U1.4 (SCL)
ACC-SDA: IC1.10 (PC0), R14.1, U1.6 (SDA)
GND: C1.1, C2.1, C3.1, C4.1, C5.1, C6.1, C7.1, C8.1, C9.1, C10.1, C11.1, C12.1, C15.1, C16.1, C17.1, C18.1, C19.1, C20.1, IC1.8 (GND1), IC1.18 (GND2), IC1.30 (GND3), IC1.38 (AGND), ISP1.4, R1.1, R2.1, R3.1, R8.2, R10.1, R16.1, R18.2, T1.E, T2.E, T3.E, T4.E, T5.E, U1.5 (GND_3), U1.7 (SA0), U1.10 (GND_2), U1.12 (GND), U$1.2 (GND), U$2.2 (GND), U$12.3, U$12.4, U$13.2 (GND), U$14.2 (GND), U$15.2 (GND), U$16.2 (GND)
HANDS: IC1.40 (PA0), R11.2
HANDS-IR: IC1.41 (PA1), R13.1
HANDS-NPN-OUT: HANDS.1, R9.2, R10.2
IR-RX: IC1.22 (PD2), U$13.1 (OUT), U$14.1 (OUT), U$15.1 (OUT), U$16.1 (OUT)
IR-TX: IC1.20 (PD0), IC1.23 (PD3), R5.1
LIGHTS-MOSI: IC1.25 (PD5), U$1.9 (STDI)
LIGHTS-SCK: IC1.27 (PD7), U$1.10 (SCKI)
unnamed: U$1.11 (SCKO), U$2.10 (SCKI)
unnamed: U$1.12 (SDTO), U$2.9 (STDI)
unnamed: R1.2, U$1.1 (IREF)
unnamed: RGB1.4 (R), U$1.3 (OUTR0)
unnamed: RGB1.2 (G), U$1.4 (OUTG0)
unnamed: RGB1.1 (B), U$1.5 (OUTB0)
unnamed: RGB2.4 (R), U$1.6 (OUTR1)
unnamed: RGB2.2 (G), U$1.7 (OUTG1)
unnamed: RGB2.1 (B), U$1.8 (OUTB1)
unnamed: RGB3.1 (B), U$1.15 (OUTB2)
unnamed: RGB3.4 (R), U$1.13 (OUTR2)
unnamed: IC1.29 (PE1), JP1.1
unnamed: RGB4.4 (R), U$1.16 (OUTR3)
unnamed: BUZZ.2, T5.C
unnamed: RGB4.1 (B), U$1.18 (OUTB3)
unnamed: RGB5.4 (R), U$2.3 (OUTR0)
unnamed: RGB5.2 (G), U$2.4 (OUTG0)
unnamed: RGB5.1 (B), U$2.5 (OUTB0)
unnamed: R18.1, R19.2, T5.B
unnamed: RGB6.2 (G), U$2.7 (OUTG1)
unnamed: RGB6.1 (B), U$2.8 (OUTB1)
unnamed: RGB8.4 (R), U$2.16 (OUTR3)
unnamed: RGB8.2 (G), U$2.17 (OUTG3)
unnamed: RGB8.1 (B), U$2.18 (OUTB3)
unnamed: RGB7.1 (B), U$2.15 (OUTB2)
unnamed: RGB7.2 (G), U$2.14 (OUTG2)
unnamed: RGB7.4 (R), U$2.13 (OUTR2)
unnamed: C2.2, IC1.37 (PR1), XT1.2
unnamed: C1.2, IC1.36 (PR0), XT1.1
unnamed: R3.2, TRIG.1
unnamed: R6.1, R17.2, TM1.S
unnamed: HANDS.4, R4.1
unnamed: R9.1, T3.B
unnamed: R11.1, R12.1, T3.C
unnamed: R2.2, U$2.1 (IREF)
unnamed: C16.2, U1.2 (BYP)
unnamed: HANDS.3, T4.C
unnamed: JP2.1, R6.2
unnamed: JP2.2, T1.C
unnamed: JP2.4, R7.1
unnamed: JP2.3, T2.C
unnamed: R5.2, R8.1, T1.B, T2.B
unnamed: IC1.28 (PE0), JP4.1
unnamed: IC1.34 (PDI_DATA), ISP1.2
unnamed: R13.2, R16.2, T4.B
unnamed: IC1.35 (RESET), ISP1.3
unnamed: C3.2, C4.2, C11.2, C18.2, C19.2, IC1.9 (VCC1), IC1.19 (VCC2), IC1.31 (VCC3), IC1.39 (AVCC), ISP1.1, L1.2
RGB3: RGB3.2 (G), U$1.14 (OUTG2)
RGB4: RGB4.2 (G), U$1.17 (OUTG3)
RGB6: RGB6.4 (R), U$2.6 (OUTR1)
RX: IC1.32 (PE2), JP4.2, U$12.1
TRIGGER: IC1.42 (PA2), TRIG.2
TX: IC1.33 (PE3), JP1.2, U$12.2
VCC: BUZZ.1, C5.2, C6.2, C7.2, C8.2, C9.2, C10.2, C15.2, C17.2, C20.2, HANDS.2, L1.1, R4.2, R7.2, R12.2, R14.2, R15.2, R17.1, TM1.E, U1.1 (VDDIO), U1.14 (VDD), U$1.19 (VCC), U$1.20 (VREG), U$2.19 (VCC), U$2.20 (VREG), U$12.5, U$12.6, U$13.3 (VCC), U$14.3 (VCC), U$15.3 (VCC), U$16.3 (VCC)
VIBRATOR: IC1.43 (PA3), R19.1

Notes on the sheet:
IR / Laser OUT
Hand Sensor
Acceleromter

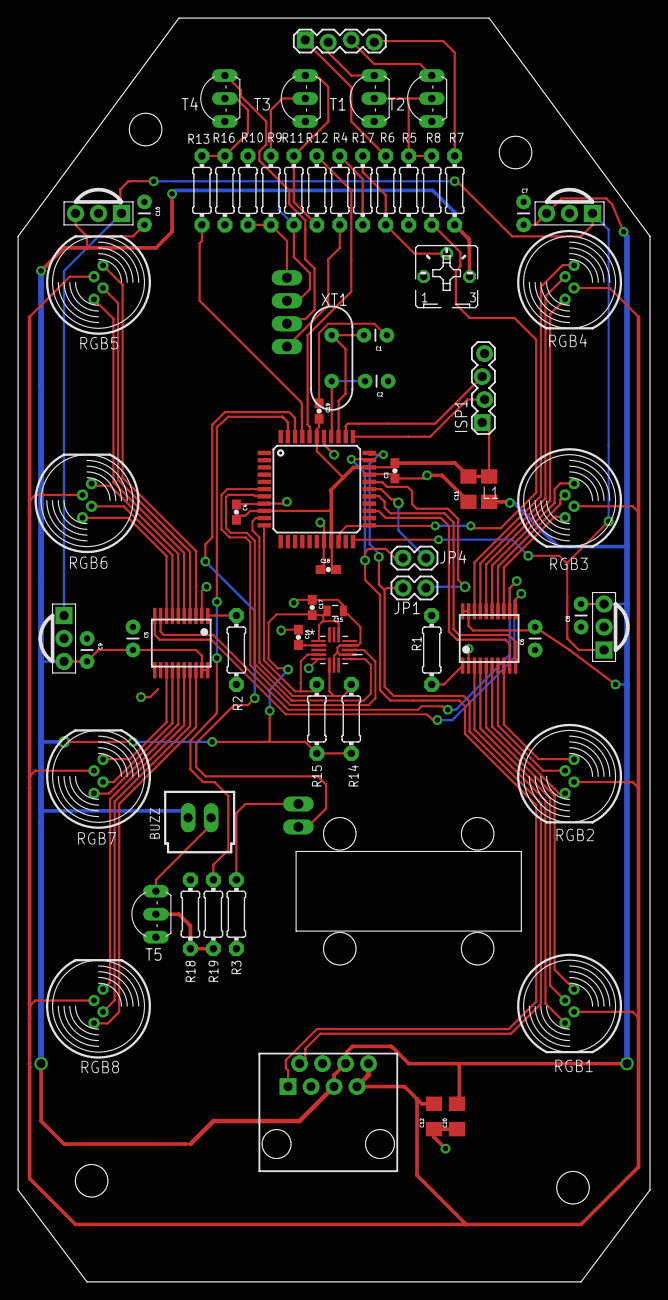
[picture p13: board phasor.brd from above]

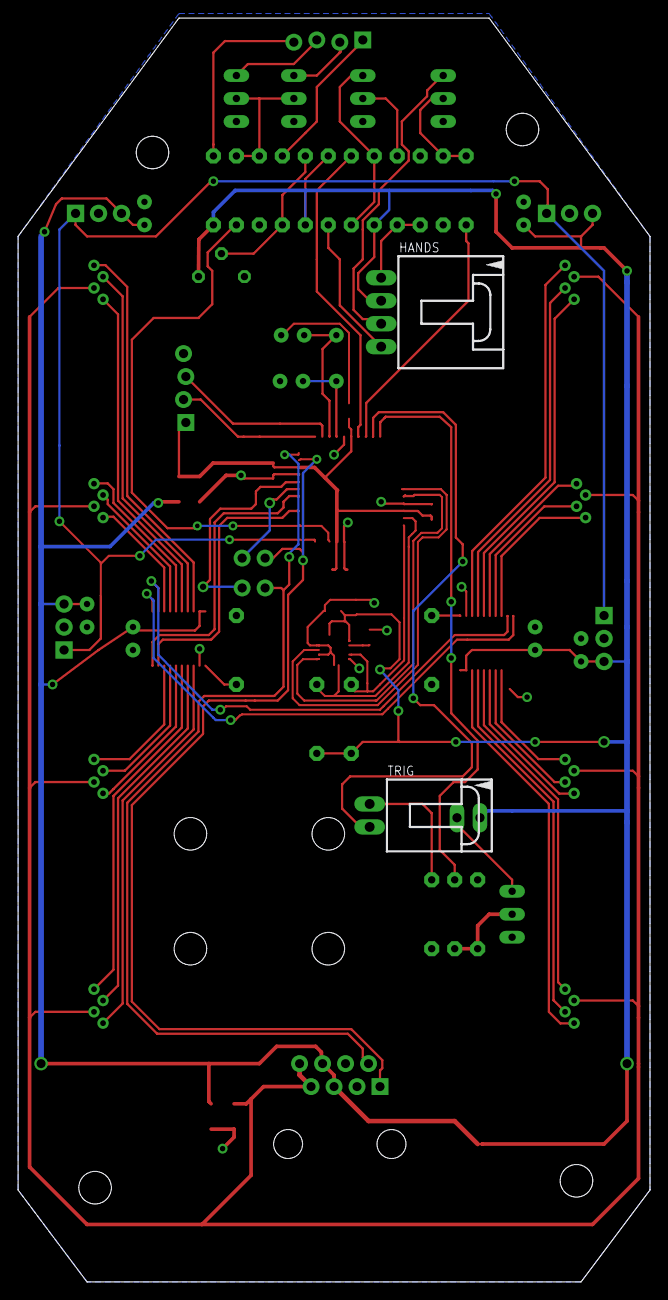
[picture p14: board phasor.brd from below]

Board: 2 copper layers, 69.8 x 139.7 mm, 70 parts (2 on the bottom side), 68 nets.
