topnotcher/gforce/master/ee/chest-xmega-rgb.brd

## EAGLE design master/ee/chest-xmega-rgb.brd (2016-08-03)

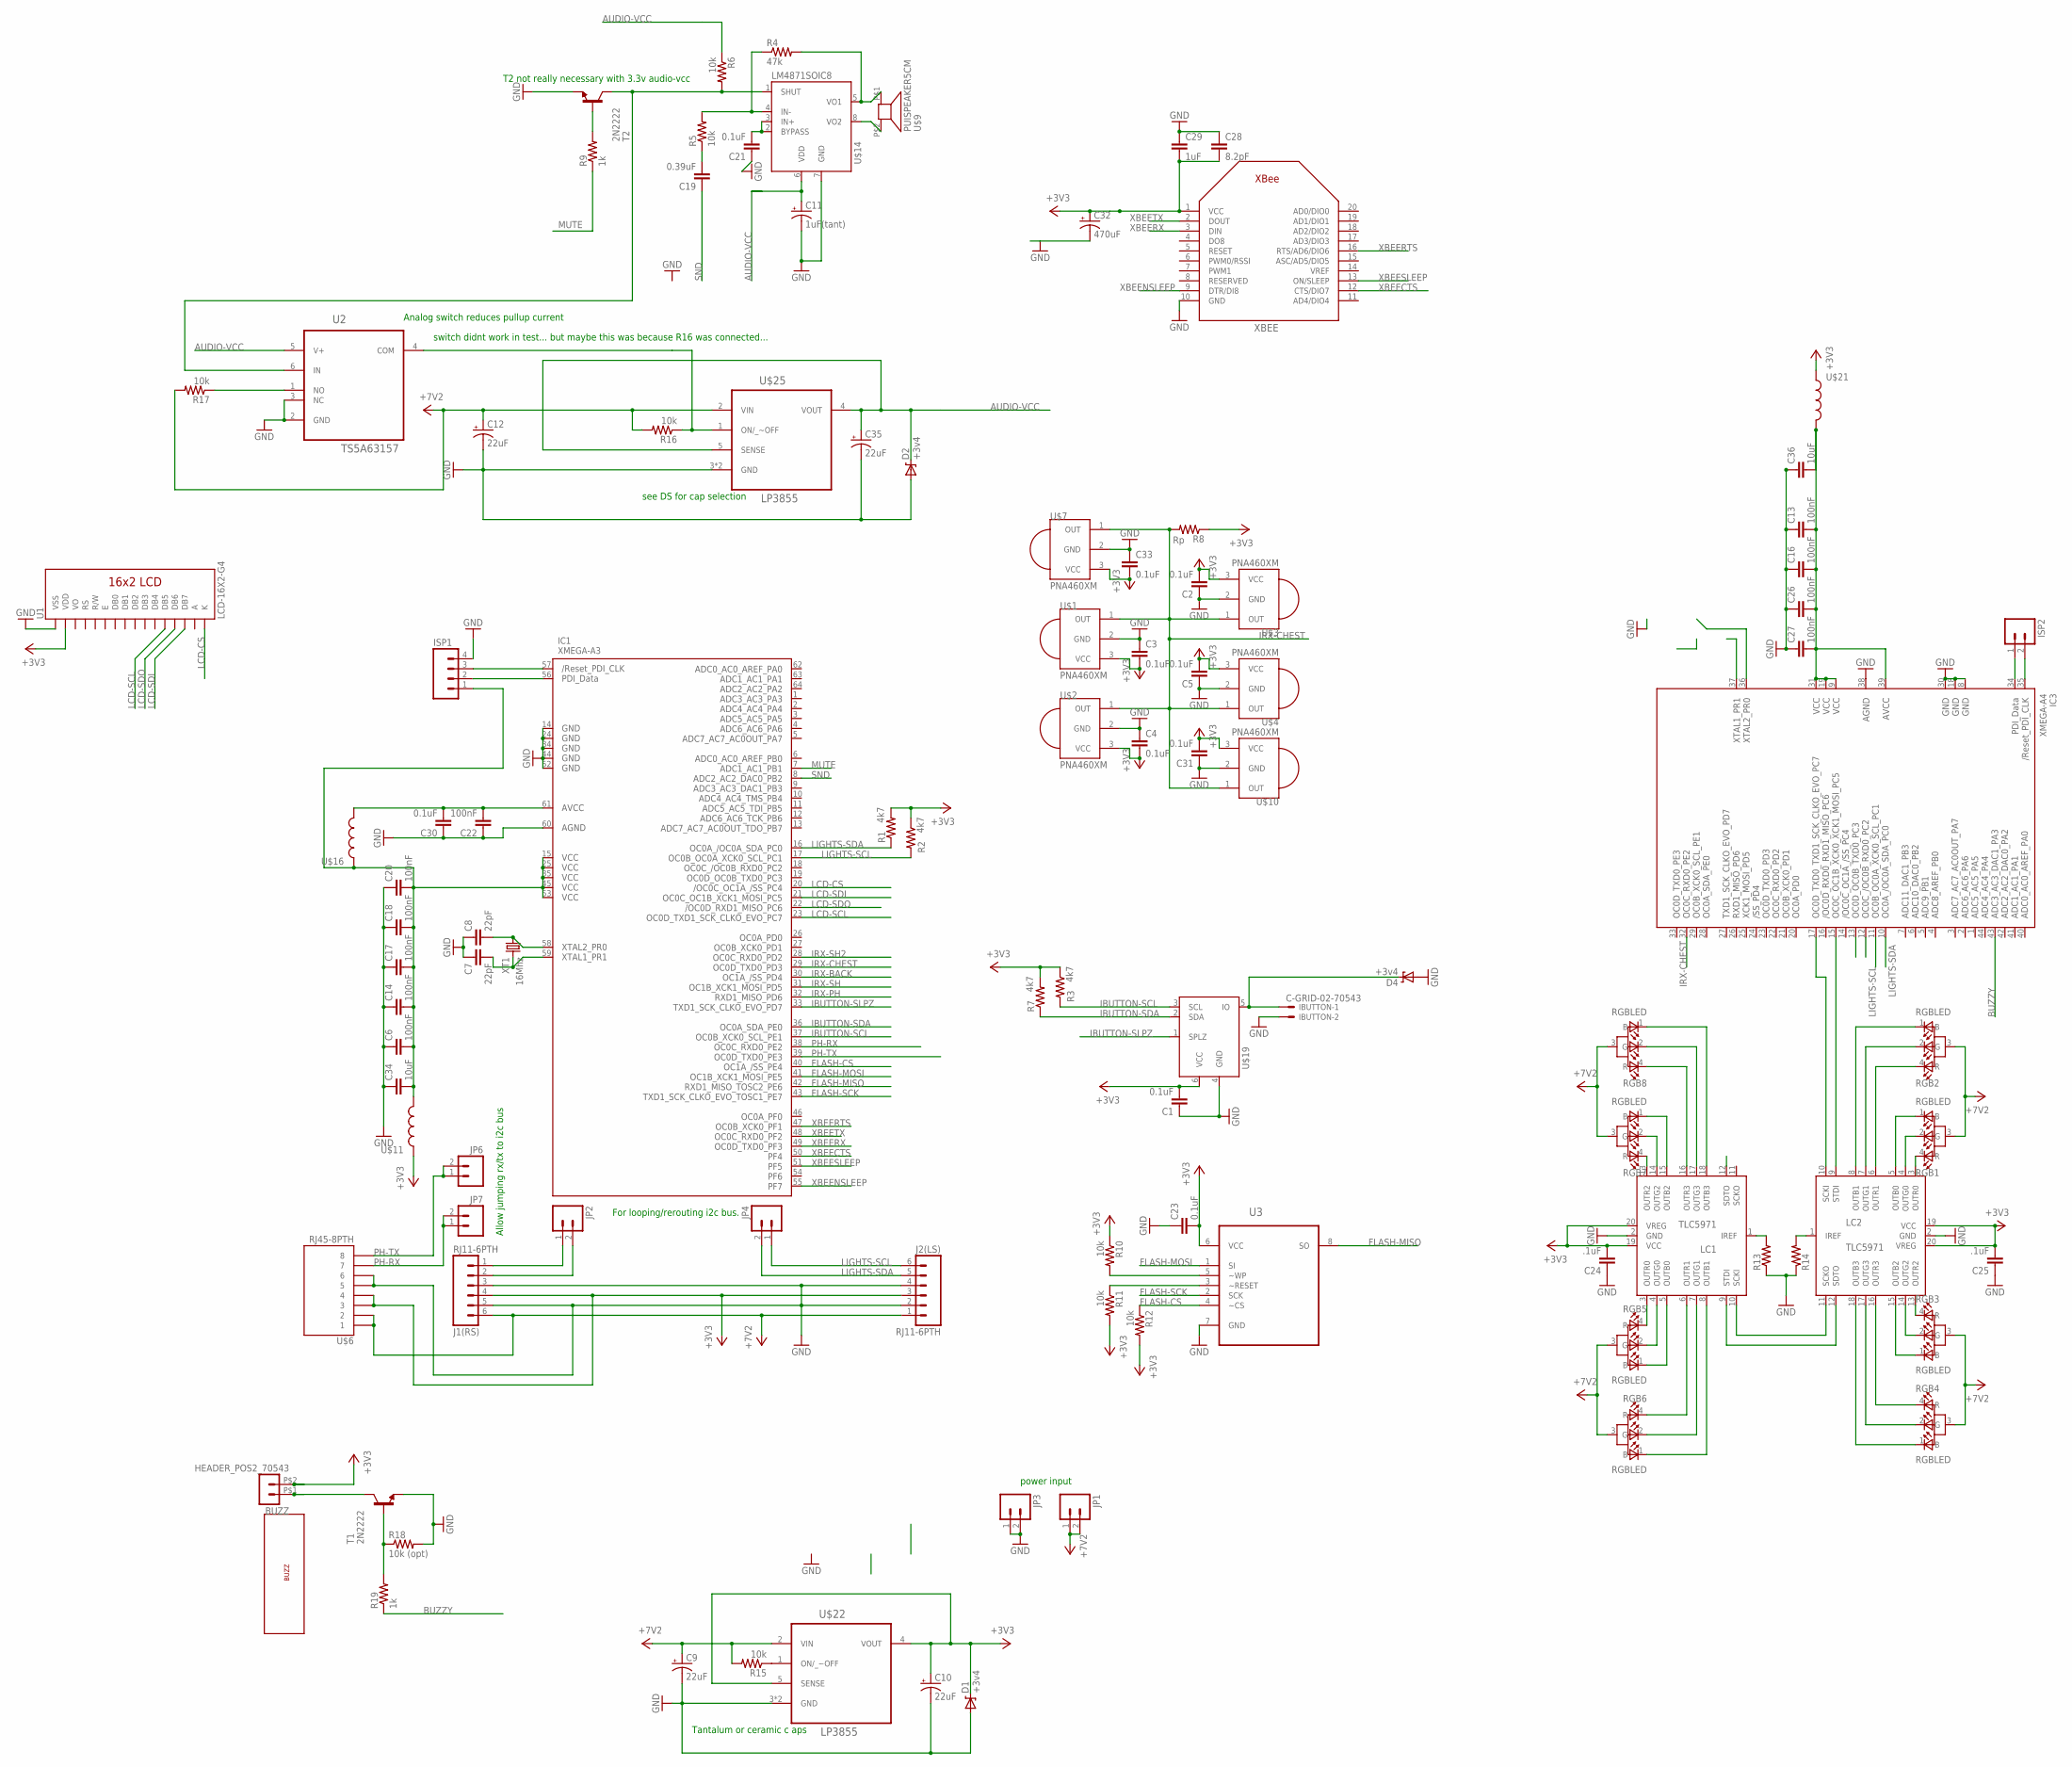
[picture p15: schematic chest-xmega-rgb.sch]

Parts:
BUZZ: HEADER_POS2_70543; 70543-POS2
C1, C23, C30: 0.1uF; 0603-CAP
C2, C3, C4, C5, C21, C31, C33: 0.1uF; CAP-PTH-SMALL
C6, C13, C14, C16, C17, C18, C20, C22, C26, C27: 100nF; 0603-CAP
C7, C8: 22pF; CAP-PTH-SMALL
C9, C10, C12, C35: 22uF; EIA3216
C11: 1uF(tant); EIA3216
C19: 0.39uF; CAP-PTH-SMALL
C24, C25: .1uF; CAP-PTH-SMALL
C28: 8.2pF; 0603-CAP
C29: 1uF; 0603-CAP
C32: 470uF; PANASONIC_E
C34, C36: 10uF; 1206
D1, D2, D4: +3v4; DIODE-ZENER
IBUTTON: C-GRID-02-70543; 70543-02
IC1: XMEGA-A3; TQFP64
IC3: XMEGA-A4; TQFP44
ISP1: M04LOCK; 1X04_LOCK
ISP2: M02LOCK; 1X02_LOCK
J1(RS), J2(LS): RJ11-6PTH; RJ11-6
JP1, JP3: M023.5MM; SCREWTERMINAL-3.5MM-2
JP2, JP4, JP6, JP7: M02LOCK; 1X02_LOCK
LC1, LC2: TLC5971; SSOP20
R1, R2, R3, R7: 4k7; 0204/7
R4: 47k; 0204/7
R5, R6, R15, R16, R17: 10k; 0204/7
R8: Rp; 0204/7
R9, R19: 1k; 0204/7
R10, R11, R12: 10k; 0805
R13, R14: R-US_0204/7; 0204/7
R18: 10k (opt); 0204/7
RGB1, RGB2, RGB3, RGB4, RGB5, RGB6, RGB7, RGB8: RGBLED; RGB-LED-10MM-COMMON-ANODE
T1, T2: 2N2222; TO92-EBC-OVAL
U1: LCD-16X2-G4
U2: TS5A63157; SOT65P210X110-6N
U3: AT45DB321D-SU; SOIC127P798X216-8N
U$1, U$2, U$3, U$4, U$7, U$10: PNA460XM
U$6: RJ45-8PTH; RJ45-8
U$9: PUISPEAKER5CM; PUI-AS05008MR-4-R
U$11, U$16, U$21: INDUCTOR1206H*; 1206
U$13: VIB-CAPSULE
U$14: LM4871SOIC8; SOIC8
U$19: DS2483-SOT23-6; SOT23-6
U$22, U$25: LP3855; TO-263-5
XBEE: XBEE-WIFIXBEE; XBEE-WIFI
XT1: 16Mhz; HC49US

Connections:
+3V3: BUZZ.P$2 (2), C1.2, C2.2, C3.2, C4.2, C5.2, C10.A (+), C23.2, C24.2, C25.2, C28.2, C29.2, C31.2, C32.+, C33.2, D1.P$1 (C), J1(RS).4, J2(LS).3, LC1.19 (VCC), LC1.20 (VREG), LC2.19 (VCC), LC2.20 (VREG), R1.2, R2.1, R3.1, R7.2, R8.1, R10.1, R11.2, R12.2, U1.2 (VDD), U3.6 (VCC), U$1.3 (VCC), U$2.3 (VCC), U$3.3 (VCC), U$4.3 (VCC), U$6.3, U$6.4, U$7.3 (VCC), U$10.3 (VCC), U$11.1, U$19.6 (VCC), U$21.1, U$22.4 (VOUT), U$22.5 (SENSE), XBEE.1 (VCC)
+7V2: C9.A (+), C12.A (+), J1(RS).6, J2(LS).1, JP1.1, JP1.2, R15.2, R16.2, R17.2, RGB1.3 (VCC), RGB2.3 (VCC), RGB3.3 (VCC), RGB4.3 (VCC), RGB5.3 (VCC), RGB6.3 (VCC), RGB7.3 (VCC), RGB8.3 (VCC), U$6.1, U$6.2, U$22.2 (VIN), U$25.2 (VIN)
A: U1.15 (A)
AUDIO-VCC: C11.A (+), C35.A (+), D2.P$1 (C), R6.1, U2.5 (V+), U$14.6 (VDD), U$25.4 (VOUT), U$25.5 (SENSE)
BUZZY: IC3.43 (PA3), R19.1
FLASH-CS: IC1.40 (PE4), R12.1, U3.4 (~CS)
FLASH-MISO: IC1.42 (PE6), U3.8 (SO)
FLASH-MOSI: IC1.41 (PE5), U3.1 (SI)
FLASH-SCK: IC1.43 (PE7), U3.2 (SCK)
GND: C1.1, C2.1, C3.1, C4.1, C5.1, C6.1, C7.1, C8.1, C9.C (-), C10.C (-), C11.C (-), C12.C (-), C13.1, C14.1, C16.1, C17.1, C18.1, C20.1, C21.1, C22.1, C23.1, C24.1, C25.1, C26.1, C27.1, C28.1, C29.1, C30.1, C31.1, C32.-, C33.1, C34.1, C35.C (-), C36.1, D1.P$2 (A), D2.P$2 (A), D4.P$2 (A), IBUTTON.2, IC1.14 (GND1), IC1.24 (GND2), IC1.34 (GND3), IC1.44 (GND4), IC1.52 (GND5), IC1.60 (AGND), IC3.8 (GND1), IC3.18 (GND2), IC3.30 (GND3), IC3.38 (AGND), ISP1.4, J1(RS).3, J1(RS).5, J2(LS).2, J2(LS).4, JP3.1, JP3.2, LC1.2 (GND), LC2.2 (GND), R13.1, R14.1, R18.2, T1.E, T2.E, U1.1 (VSS), U2.2 (GND), U2.3 (NC), U3.7 (GND), U$1.2 (GND), U$2.2 (GND), U$3.2 (GND), U$4.2 (GND), U$6.5, U$6.6, U$7.2 (GND), U$10.2 (GND), U$14.7 (GND), U$19.4 (GND), U$22.3 (GND), U$22.TAB (GND), U$25.3 (GND), U$25.TAB (GND), XBEE.10 (GND)
IBUTTON-SCL: IC1.37 (PE1), R3.2, U$19.3 (SCL)
IBUTTON-SDA: IC1.36 (PE0), R7.1, U$19.2 (SDA)
IBUTTON-SLPZ: IC1.33 (PD7), U$19.1 (SPLZ)
IRX-BACK: IC1.30 (PD4)
IRX-CHEST: IC1.29 (PD3), IC3.32 (PE2), R8.2, U$1.1 (OUT), U$2.1 (OUT), U$3.1 (OUT), U$4.1 (OUT), U$7.1 (OUT), U$10.1 (OUT)
IRX-PH: IC1.32 (PD6)
IRX-SH: IC1.31 (PD5)
IRX-SH2: IC1.28 (PD2)
LCD-CS: IC1.20 (PC4), U1.16 (K)
LCD-SCL: IC1.23 (PC7), U1.12 (DB5)
LCD-SDI: IC1.21 (PC5), U1.14 (DB7)
LCD-SDO: IC1.22 (PC6), U1.13 (DB6)
LIGHTS-SCL: IC1.17 (PC1), IC3.11 (PC1), J2(LS).6, JP4.1, R2.2
LIGHTS-SDA: IC1.16 (PC0), IC3.10 (PC0), J2(LS).5, JP4.2, R1.1
MUTE: IC1.7 (PB1), R9.1
unnamed: LC1.10 (SCKI), LC2.11 (SCKO)
unnamed: LC1.9 (STDI), LC2.12 (SDTO)
unnamed: IC3.15 (PC5), LC2.9 (STDI)
unnamed: IC3.17 (PC7), LC2.10 (SCKI)
unnamed: IC3.34 (PDI_DATA), ISP2.1
unnamed: IC3.35 (RESET), ISP2.2
unnamed: IC1.57 (RESET), ISP1.3
unnamed: IC1.56 (PDI_DATA), ISP1.2
unnamed: C7.2, IC1.59 (PR1), XT1.2
unnamed: C6.2, C14.2, C17.2, C18.2, C20.2, C34.2, IC1.15 (VCC1), IC1.25 (VCC2), IC1.35 (VCC3), IC1.45 (VCC4), IC1.53 (VCC5), ISP1.1, U$11.2, U$16.1
unnamed: C13.2, C16.2, C26.2, C27.2, C36.2, IC3.9 (VCC1), IC3.19 (VCC2), IC3.31 (VCC3), IC3.39 (AVCC), U$21.2
unnamed: J1(RS).1, JP2.1
unnamed: C8.2, IC1.58 (PR0), XT1.1
unnamed: LC1.15 (OUTB2), RGB7.1 (B)
unnamed: J1(RS).2, JP2.2
unnamed: R10.2, U3.5 (~WP)
unnamed: R17.1, U2.1 (NO)
unnamed: C22.2, C30.2, IC1.61 (AVCC), U$16.2
unnamed: LC1.13 (OUTR2), RGB7.4 (R)
unnamed: R11.1, U3.3 (~RESET)
unnamed: R4.1, R5.2, U$14.4 (IN-)
unnamed: LC1.14 (OUTG2), RGB7.2 (G)
unnamed: D4.P$1 (C), IBUTTON.1, U$19.5 (IO)
unnamed: U$9.P$2 (2), U$14.8 (VO2)
unnamed: R4.2, U$9.P$1 (1), U$14.5 (VO1)
unnamed: LC1.16 (OUTR3), RGB8.4 (R)
unnamed: LC1.17 (OUTG3), RGB8.2 (G)
unnamed: LC1.18 (OUTB3), RGB8.1 (B)
unnamed: C19.2, R5.1
unnamed: LC1.3 (OUTR0), RGB5.4 (R)
unnamed: LC1.4 (OUTG0), RGB5.2 (G)
unnamed: LC1.5 (OUTB0), RGB5.1 (B)
unnamed: LC1.6 (OUTR1), RGB6.4 (R)
unnamed: LC1.7 (OUTG1), RGB6.2 (G)
unnamed: LC1.8 (OUTB1), RGB6.1 (B)
unnamed: LC2.3 (OUTR0), RGB1.4 (R)
unnamed: LC2.4 (OUTG0), RGB1.2 (G)
unnamed: LC2.5 (OUTB0), RGB1.1 (B)
unnamed: BUZZ.P$1 (1), T1.C
unnamed: R15.1, U$22.1 (ON/_~OFF)
unnamed: C21.2, U$14.2 (BYPASS), U$14.3 (IN+)
unnamed: R18.1, R19.2, T1.B
unnamed: LC2.6 (OUTR1), RGB2.4 (R)
unnamed: LC2.7 (OUTG1), RGB2.2 (G)
unnamed: LC2.8 (OUTB1), RGB2.1 (B)
unnamed: LC2.16 (OUTR3), RGB4.4 (R)
unnamed: LC2.17 (OUTG3), RGB4.2 (G)
unnamed: LC2.18 (OUTB3), RGB4.1 (B)
unnamed: LC2.15 (OUTB2), RGB3.1 (B)
unnamed: LC2.14 (OUTG2), RGB3.2 (G)
unnamed: LC2.13 (OUTR2), RGB3.4 (R)
unnamed: R6.2, T2.C, U2.6 (IN), U$14.1 (SHUT)
unnamed: LC1.1 (IREF), R13.2
unnamed: LC2.1 (IREF), R14.2
unnamed: R9.2, T2.B
unnamed: R16.1, U2.4 (COM), U$25.1 (ON/_~OFF)
PH-RX: IC1.38 (PE2), JP7.1, JP7.2, U$6.7
PH-TX: IC1.39 (PE3), JP6.1, JP6.2, U$6.8
SND: C19.1, IC1.8 (PB2)
XBEECTS: IC1.50 (PF4), XBEE.12 (CTS/DIO7)
XBEENSLEEP: IC1.55 (PF7), XBEE.9 (DTR/DI8)
XBEERTS: IC1.47 (PF1), XBEE.16 (RTS/AD6/DIO6)
XBEERX: IC1.49 (PF3), XBEE.3 (DIN)
XBEESLEEP: IC1.51 (PF5), XBEE.13 (ON/SLEEP)
XBEETX: IC1.48 (PF2), XBEE.2 (DOUT)

Notes on the sheet:
For looping/rerouting i2c bus.
Allow jumping rx/tx to i2c bus
power input
Tantalum or ceramic c aps
Analog switch reduces pullup current
T2 not really necessary with 3.3v audio-vcc
switch didnt work in test... but maybe this was because R16 was connected...
see DS for cap selection

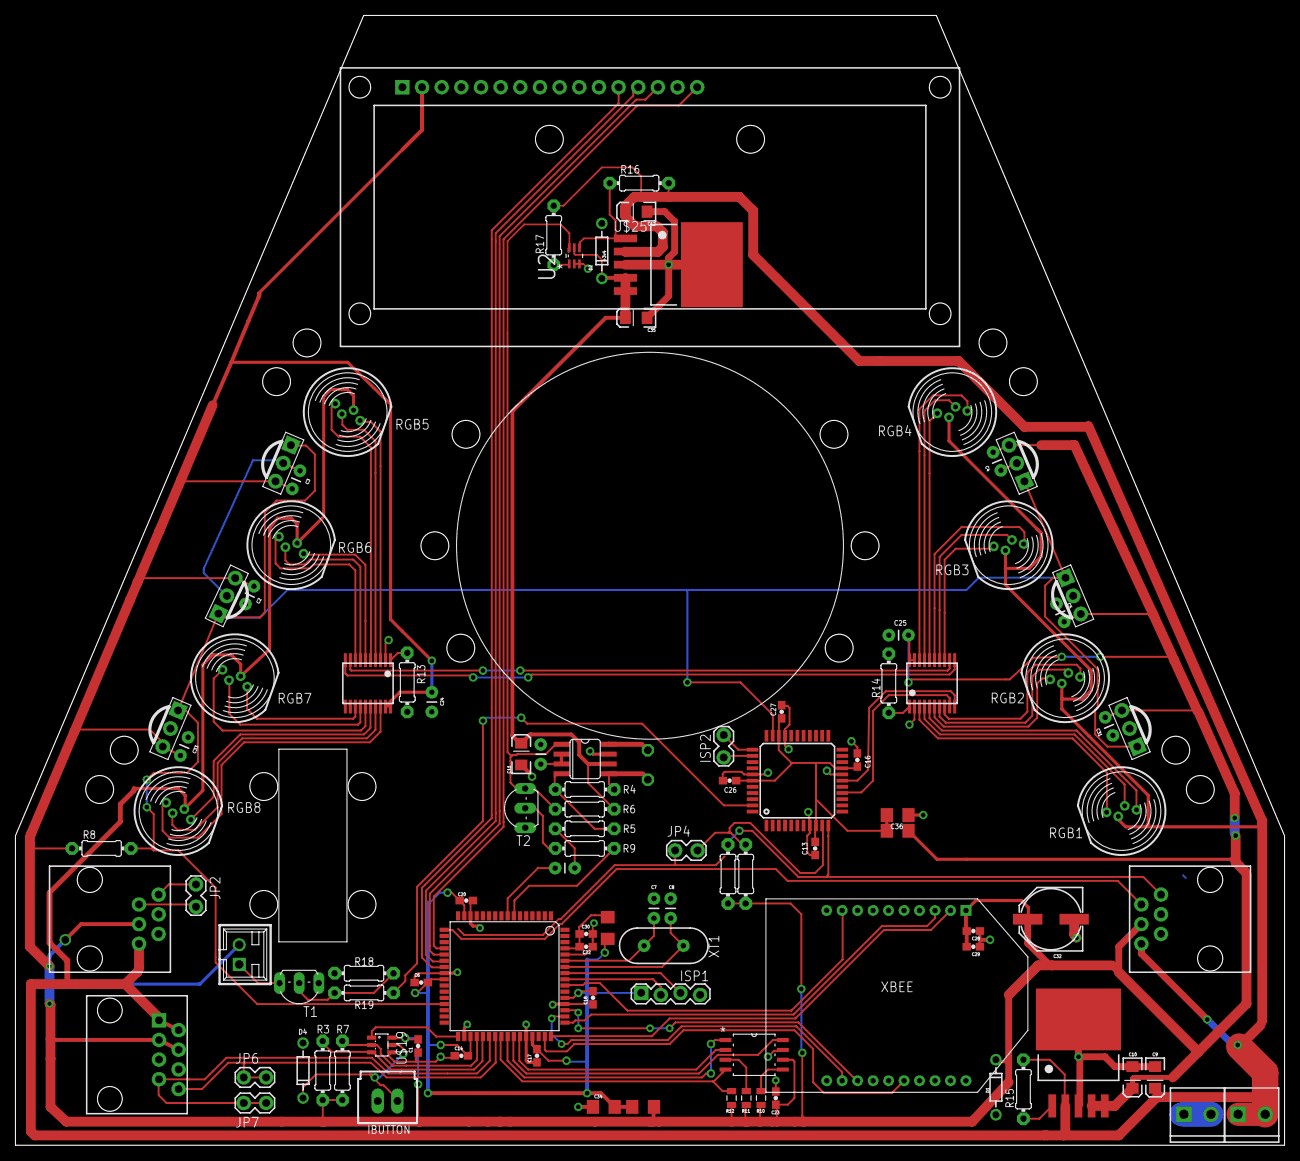
[picture p16: board chest-xmega-rgb.brd from above]

Board: 2 copper layers, 164.0 x 146.0 mm, 104 parts (0 on the bottom side), 85 nets.
