topnotcher/gforce/common/include/g4config.h

#ifndef G4_CONFIG_H
#define G4_CONFIG_H

/* BAUD: 32000000/(2*400000) - 5 = 35*/
#define MPC_TWI_BAUD 35
#define MPC_DISABLE_CRC 1

#define IR_BAUD 1515.762
#define IR_USART_BSEL 164
#define IR_USART_BSCALE 3

//#define PHASOR_COMM_BSEL_VALUE 12
//#define PHASOR_COMM_BSCALE_VALUE 4

#define PHASOR_COMM_BSEL_VALUE 3
#define PHASOR_COMM_BSCALE_VALUE 0

#endif
