topnotcher/gforce/common/mempool.c

#include <malloc.h>

#include "mempool.h"

#define block(pool, i) ((mempool_block_t *)(((uint8_t *)pool) + sizeof(*pool) + i *(sizeof(pool->blocks[0]) + pool->block_size)))

/**
 * Implement a reference counted memory pool allocator. The pool contains size
 * blocks of block_size. All blocks are reference counted with the reference
 * count being set to 1 on mempool_alloc(). Calls to mempool_getref() and
 * mempool_putref() increase and decrease the reference count, respectively.*/
mempool_t *init_mempool(const uint8_t block_size, const uint8_t size) {
	mempool_t *pool;

	pool = (mempool_t *)smalloc(sizeof(*pool) + size * (sizeof(mempool_block_t) + block_size));
	pool->size = size;
	pool->block_size = block_size;

	#pragma GCC diagnostic push
	#pragma GCC diagnostic ignored "-Wcast-align"

	for (uint8_t i = 0; i < size; ++i)
		block(pool, i)->refcnt = 0;

	#pragma GCC diagnostic pop

	return pool;
}

void *mempool_alloc(mempool_t *pool) {
	void *ret = NULL;

	portENTER_CRITICAL(); {

	#pragma GCC diagnostic push
	#pragma GCC diagnostic ignored "-Wcast-align"
		for (uint8_t i = 0; i < pool->size; ++i) {
			mempool_block_t *block = block(pool, i);
			if (block->refcnt == 0) {
				ret = block->block;
				block->refcnt = 1;
				break;
			}
		}
	#pragma GCC diagnostic pop

	} portEXIT_CRITICAL();

	return ret;
}

extern inline void *mempool_getref(void *buf);
extern inline void mempool_putref(void *buf);
