topnotcher/gforce/(commit log)

2013-04-19 all 4 vest boards turn on w000000
2013-04-19 All the boards are responding to addresess correctly
    [config.h, main.c, mpc.c, mpc.h]
2013-04-20 send sequence over twi.. not working
    [mpc.c]
2013-04-20 send an led sequence to the thingythingythingy
2013-04-20 BASIC ASS MOTHERFUCKING PACKET RECEIVING AND SHIT WORKS. BUUHAH also led seq
2013-04-20 Make the TWI interrupt configurable
2013-04-20 this probably does not work
    [main.c, mpc.c, mpc.h]
2013-04-20 for symlinking files to the individual boards
2013-04-20 fix shoulder buzzing - dont fuck with eeprom
    [main.c]
2013-04-21 invert the usart output :)
    [irtx.c]
2013-04-21 this works to trigger an interrupt when the value changes, we think...
2013-04-21 clean up the led sequences
2013-04-21 python program for caluclating uart buad values`
2013-04-21 Make the timer moar configurable
2013-04-21 macros for trigger pin configuration
2013-04-21 change led pin constants to use numbers
2013-04-21 make sure timer pin is low
2013-04-21 Move the TWI ADDRMASK to the board config
2013-04-21 Move master configuration to the board config
2013-04-22 fix queue empty shit
    [mpc.c, xbee.c]
2013-04-22 fix length of queued packet
    [mpc.c]
2013-04-22 fix setting the led sequence
    [main.c]
2013-04-23 change makefile options, fix errors...
    [buzz.c, config.h, g4config.h, game.h, irrx.c, irtx.c, leds.c, leds.h]
2013-04-24 Hmm... sort of works, but crashes
    [leds.c, main.c]
2013-04-25 fix a probably very gay error
    [irrx.c]
2013-04-28 fix off by one errors.
    [irrx.c]
2013-04-28 temp fix the case where the read queue is empty, but write is being filled
    [irrx.c]
2013-04-28 comments, fix name of queue
    [irrx.c]
2013-04-28 Undo using scheduler for LEDS: It is CRASHING the micro!
    [irrx.c, leds.c, main.c]
2013-04-28 Fix a potential packet drop
    [mpc.c]
2013-04-28 disable trigger interrupts when the trigger is disabled
2013-04-29 Uart code - untested
2013-04-29 replace xbee interface (not working)
    [main.c, uart.c, uart.h, xbee.c, xbee.h]
2013-04-29 move the uart stuff to include/
2013-04-29 dont enable interrupts at init
2013-04-29 scheduler for leds again
2013-04-30 working covnert to SPI
2013-05-01 reverse order of args in xbee_send
    [xbee.c, xbee.h]
2013-05-04 fix start byte on TX
    [uart.c, uart.h]
2013-05-05 enable interrupt levels
2013-05-05 configure SPI ISR for LED
2013-05-07 chnage phasor baud rate, make all boards work
2013-05-08 init uart tx state to idle
2013-05-10 fix not moving to next queued packet on TX finish
    [mpc.c]
2013-05-12 Cuts a ton of instructions out of the UART RXC ISRs
2013-05-12 tweak the LED timing
2013-05-12 Fix a issue with the trigger dying (causes other issue).
    [trigger.c]
2013-05-12 oled adp board - initial
2013-05-12 switch to 8-bit mode
2013-08-17 generalize uart driver a bit so it works with SPI
2013-08-17 remove LCD code as it now belongs in the oled board.
2013-08-17 TX to OLED via "uart" driver
2013-08-17 fix SS being backwards?
    [display.c, leds.c]
2013-08-17 fix SS compatibility with SPI when ending a transmit.
    [uart.c]
2013-08-17 add tx interrupt
2013-08-17 print strings to OLED via SPI
2013-08-17 display sensor initials on IR receive
2013-08-18 add scheduler to all boards
2013-08-18 switch to central scheduler.c
2013-08-18 fix updating led sequence while lights are on
    [leds.c]
2013-08-18 fix hard-coded stun time.
    [game.c]
2013-09-02 display sensor when shot.
2013-09-05 prettier printing of tagged sensor
2013-09-05 make irtx driver support a repeat count.
2013-09-18 remove dynamic memory allocation from UART (horribly broken still)
    [display.c, uart.c, uart.h, xbee.c]
2013-09-18 temp fix - dont free static allocation
    [main.c, uart.c]
2013-09-19 get chest board to compile (without irrx)
2013-09-19 dont allocate led_sequence dynamically
2013-09-20 fix processing too early??
    [mpc.c]
2013-09-20 make uart tx use static allocation
2013-09-20 this led timing looks better
2013-09-21 add smalloc() to other boards
2013-09-27 This splits MPC and the TWI driver.
    There were three major goals
    (1) Split MPC and TWI (since phasor_comm should also be part of MPC
    (2) Allow buffers to be shared between all MPC components
    - This reduces the amount of memory required in separate static
    buffers. The 8 buffers used by MPC_TWI (RX and TX) are now
    replaced by 8 total buffers, which will later be shared with
    phasor_comm
    (3) Split the common parts of all of the communications code (uart,
    spi, twi) into a common packet-based communications layer. This is
    partially implemented, but needs a lot more work.
    In addition:
    - TWI now uses proper queues for RX and TX. At some point these
    should block.
    - TWI doe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
    [main.c, mpc.c, mpc.h]
2013-09-29 regression: order of arguments to *_send(...)
    fixes regressions in chest,back,shoulder, phasor that caused compile
    errors due to chaning the order of arugments in phasor_comm_send() and
    mpc_send()
    [main.c]
2013-09-29 track a file that should have been added already
    should have been added in d2d5b3a23c988551f5479d421aad10cecd16e5aa
2013-09-29 mpc: wrap board-specific in #ifdef
2013-09-29 uart regression: rename of MPC_ADDR
    Fix regregssion caused by 802bfda19cc2736352e8a200b7c30bf5197e04a6
    [uart.c]
2013-09-29 comm: serialdev driver to replace uart.c
    serialdev driver to (eventually) replace the uart.c driver used for
    phasor_comm, displa and xbee
    [serialdev.c]
2013-09-29 comm: rework phasor_comm to use serialdev and comm.
    Only TX works.
    [main.c]
2013-09-30 mpc: merge phasor_comm into mpc
    phasor_comm completely moved into MPC - no more phasor_comm_send or
    phasor_comm_recv().
    - ONLY tx is working
    MPC_ board addresses added to g4config.h
    - Addresses are "7-bit" with the left bit reserved.
    - TWI must shift the addresses left itself.
    Intended ONLY for master at this point - no conditional compilation for
    boards without one of the mpc comm interfaces
2013-09-30 comm: macro to determine size of currently txed frame
2013-09-30 serialcomm: change transmitted frame header
    header is now 4 bytes: start, destination address, length, checksum.
    The "checksum" is a simple xor of the destination and length, with the 1
    bit masked out (to ensure that it is never 0xFF, which is the start
    byte.) This should ensure that the receiver is able to synchronize
    better
2013-09-30 mpc: fix a memleak if CRC fails
    [mpc.c]
2013-10-05 mpc: fix a logic error that prevented pkts from sending
    Fixes an issue that begin with 4cf1605299c06df111acf15cf2e94eb2d52cc562,
    where the mpc master would not transmit any messages.
    [mpc.c]
2013-10-05 mpc: change twi address mask
    This puts the phasor in the address mask used by the chest, shoulder,
    back. Even though the phasor is not on the TWI bus, this allows those
    boards to receive TWi transactions with the phasor address bit set.
2013-10-05 mpc: fix typo
    Typo in MPC_TWI_SLAVE_ISR caused the ISR not to run
    [mpc.c]
2013-10-06 mpc/serialcomm/comm: Add serialcomm receiver
    Adds serial comm receiver with a [probably really stupid] frame
    synchronizer. The synchronizer runs constantly, and begins trying to
    syncrhonize whenever it sees 0xFF. If a frame is being received while
    synchronization is running, the data is received as normally. When the
    syncrhonizer detects a valid 4-byte 'start sequence' (0xff, dest
    address, pkt length, check), any active RX is ended, and a new RX is
    started. Since the syncrhonizer restarts whenever 0xFF is received,
    none of the bytes in the frame header can be 0xFF - this means the size
    is limited to 0xFE and the check must not be 0xFF. The check is defined
    as: ((destination address)^(si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
2013-10-06 game: fix game ending during a stun.
    [game.c]
2014-02-15 Enable battery charging
2014-02-15 Send test ping to chest board
2014-02-15 print received packets
2014-02-15 Fix off by 1 in received packets
    Need to increment pointer by 1 to seek past the start byte
    [main.c]
2014-02-15 Fix reporting shots when a shot was not actually received
    [game.c]
2014-02-15 copy ping reply code to all boards
2014-02-15 fix backwards arguments in mpc_send_cmd
    [main.c]
2014-02-15 Print packet data
2014-02-15 Ping all sensors and print replies
2014-02-15 function to get board name string from address
2014-02-15 Print out shots received
2014-02-19 Veryveryvery basic charger driver to read faults
2014-02-19 Split up twi_mater_isr
    Add separate functions for write/read interrupts
2014-02-19 Split twi slave into a separate file/device
2014-02-19 update other boards to use new twi code
2014-02-22 convert chest, back, shoulders and leds to use eventq
2014-02-22 Fix mpc src address issues with the phasor
    [mpc.c]
2014-02-23 Change TWI address mask
    seems to fix some issues when addresses are directed at the phasor and
    that bit is not masked out
    [config.h]
2014-02-23 Fix sensor IDs for deac/stun
    [game.c]
2014-02-23 Use lower bitrate, fix dummy address
    [display.c]
2014-02-23 fix deac handling
    - set game state to inactive when deaced
    - set countdown_cb to player_activate
    [game.c]
2014-02-24 Make sounds work by using a timer other than the RTC :D
2014-03-01 Add configuration options for one wire master
2014-03-02 fiddle with xbee flow control and sleep mode
2014-03-02 Fix off-by-one error in TWI Master Read handling
    The TWI master read handler would receive one more byte than intended.
    This causes the master to issue a NAK and a STOP immediately after
    receiving the last byte so no more bytes are received.
    [twi_master.c]
2014-03-06 Add retry to failed TWI master transactions
    Certain TWI master error conditions will be retried automatically:
    - Bus arbitration lost
    - NAK from slave
    The entire remaining part of the transaction will be restarted up to
    TWI_MASTER_MAX_RETRIES times.
    [twi_master.c]
2014-03-07 Scheduled polling for an iButton
    Polls for an iButton every 300ms on a timer
2014-03-07 Missing one wire wait
2014-03-08 move *_stack definitions to threads.c
2014-03-08 generalize, move into threads.c|h
2014-06-07 scheduler: remove ATOMIC_BLOCK from scheduler_remove_node
    scheduler_remove_node is either called from SCHEDULER_RUN or
    scheduler_register. In the former case, interrupts are already disabled,
    so there's no need fir the atomic block. Instead only wrap
    scheduler_unregister
2014-06-07 charger: alter various charging limits
    - charging time limit from 8 to 12 hours.
    - charged voltage to 4.208v
2014-10-11 chunkpool: replace incref/decref with getref/putref
    [display.c, mastercomm.c, mpc.c]
2014-10-11 scheduler: rename to timer
2014-10-11 timer: rename functions
    timer_init -> init_timers
    timer_register -> add_timer
    timer_unregister -> del_timer
2014-10-11 timer: rename task_ structures to timer_
2014-10-11 timer: task_freq_t -> task_ticks_t
2014-10-11 timer: rename TASK contants to TIMER
2014-10-11 timer: remove initialization of static
2014-10-11 timer: comments
2014-10-11 timer: split up add_timer
2014-10-11 timer: cosmetic changes
    spit some functions, change/add comments, etc
2014-10-11 mpc: move some macros so the C flows better
2014-10-11 game: defer updating the display
    Running the display update directly via the scheduler causes it to be
    run in interrupt context; this defers it until after the interrupt.
2014-10-12 timer: fix various bugs in reorder()
    introduced in d680ac29c4c204654da245c2a9cc3e83eeb107e5
2014-10-14 timer: handle list reordering more cleanly.
    Instead of reordering the list after tasks are run, simply recreate the
    list by adding tasks back. (There may be a larger performance overhead
    this way?)
2014-10-14 timer: remove a function
2014-10-14 timer: remove unused macro
2014-10-14 timer: remove uneeded "inline"s
2014-10-18 threads: make the main thread an actual thread.
2014-10-26 TWI: zero device memory before use.
2015-01-01 timer: bugfixes from yobot
2015-01-01 game: avoid manipulating timers from timers.
    [game.c, game.h]
2015-01-27 threads: generic block()
2015-01-29 game: do not call stop_game() from timer context
    ... also remove trailing spaces :|
2016-04-05 much improved build
    - common files are no longer symlinked.
    - They get built with output in common/output/<board>/
    - Header file dependencies.
    [buzz.c, config.h, irrx.c, leds.c, malloc.c, mempool.c, mpc.c]
2016-08-02 add common MPC diagnostic commands for all slave boards.
    I - echo back a packet as if it were received via IR
    R - reply to a ping
2016-08-03 threads: use a [more] "real" scheduler with variable number of threads
    - No longer require two hard-coded threads.
    - twi_master records thread id of suspended thread and uses the thread
    id to resume.
    - when threads become runable, they are put in a run queue.
    - Added thread_yield() for a thread to voluntarily yield the CPU
    - main_thread always yields after processing tasks. (this could be
    better)
    - Added thread_suspend() to allow a thread to suspend itself (or a
    device to do so, e.g. twi_master).
    [main.c, twi_master.c]
2016-08-03 threads: add a (make shift) idle task
    - temp: make tasks suspend and wake the main thread.
    - temp: make idle thread yield periodically
    - add thread_wake_and_schedule to schedule a thread and switch to the
    highest priority task.
2016-08-03 master: add board and schematic files
    - Current brd/sch files.
    - PDFs of current files.
    [chest-xmega-rgb.brd, chest-xmega-rgb.sch]
2016-08-03 shoulder: add board and schematics
    [shoulder.brd, shoulder.sch]
2016-08-03 phasor: add board and schematic files
    [phasor.brd, phasor.sch]
2016-08-03 move initialization to main thread
2016-08-09 change 32MHz clock enable to use internal 32mhz osc
    - Enable 32MHz internal oscillator
    - Enable internal 32Hkz oscillator
    - Enable DFLL32M and set reference to 32Khz oscillator
    - set system clock to 32MHz oscillator
    [util.c]
2016-08-12 move to FreeRTOS
    This is a really huge commit that really should have been split up :).
    - strip out old nasty threads.
    - make "tasks" use FreeRTOS queues.
    - make display transmit a task
    - Make LEDs a task
    - Stack overflows suck
    - Rewrite Infrared RX code as a FreeRTOS task
    - Build needs a *lot* of work.
    - -WError is removed for now
    - add -ffunction-sections, -fdata-sections and -gc-sections
    - Make ibutton use a FreeRTOS task
2016-08-12 leds: add a missing parameters :'(
    Did I even build this?
    [leds.c]
2016-08-13 timers: Run timers in a thread
    - remove all use of task_schedule_isr
    - move port(SAVE|RESTORE)_CONTEXT to portmacro.h
    - define portYIELD_FROM_ISR() (I don't think we need this - not using
    reti)
    - remove usages of xTaskNotifyFromISR()
    - lock the timer task list with a mutex.
    part 3: lock the timer task list with a mutex.
2016-08-16 remove old uart code
2016-08-16 part VII: make game events process in a task
    - Create game_event struct and game_event_type enum.
    - pass game_event structs via a queue.
    - handle game events in thread's main loop.
    - Add reference counting interface to mpc:
    - mpc_incref() / mpc_putref()
    - This allows us to pass an mpc_pkt* around threads safely (rather
    than memcpying it everytime)
    - Each mpc_pkt* is actually (comm_frame_t*)->data, which is
    reference counted by mempool_getref() / mempool_putref(). Given
    the mpc_pkt*, we simply work back to the comm_frame_t* and use
    mempool to reference count the mpc_pkt.
2016-08-18 part X: update shoulder to remove main thread and tasks
2016-08-18 part XI: remove main_thread and tasks from back
    - Make a thread for the charger...
    - This is horrible and needs fixing.
    - Derp derp
    [charger.c, main.c]
2016-08-18 part XII: don't quite remove tasks / main thread from phasor.
    - But rip out unneeded parts of tasks:
    - tasks_run is gone: it is all done in a thread created in
    tasks_init()
2016-08-19 phasor: actually start LED and IRRX tasks :)
2016-08-19 diag: make simulated IR come from any board we want
2016-08-19 Add commands to adjust LED brightness
    This saves ~300mA while active.
2016-08-26 Fix memory usage reporting....
    Heap usage was being accounted for in mem_data and mem_heap_stack, so...
    uhhh.. I got rekt.
    [malloc.c]
2016-08-26 leds: make COLOR_ACTIVE configurable
    COLOR_ACTIVE can be changed to one of the other colors
2016-08-26 implement COLOR_ACTIVE support - Part I
    - Create a "board hello" protocol where any board other than the master
    sends a "hello" to the master on booting.
    - On booting, the master listens for board hellos for ten seconds, and
    sends hellos to any boards that have not sent a hello.
    - When a slave receives a hello from the master, it replies with the
    a hello.
    - When the master receives a hello from a slave, it replies with the
    "current settings"
    - This is a TODO: at the moment, it just sets the active color.
    - Change led_active_pattern to use COLOR_ACTIVE
    - Add a new light pattern, led_booting, which sent when the master is
    booting (the 10 second window) and receives a boar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
2016-08-27 led: remove sclk_trigger() and reduce SPI frequency
    sclk_trigger() - not needed. We don't actually need to pulse the clock
    line -- just leave it level.
    Also the high frequency was triggering false data latches since it
    couldn't clock the bytes in fast enough.
2016-08-29 shoulder: change MCU to match rev2 boards
    ... this is a completely unnecessary upgrade at the moment
2016-08-29 leds: support USART in SPI master mode
2016-08-30 leds: use DMA when using USART in SPI master mode
2016-08-30 shoulder: schematic updates for new board
    - all through hole resistors replaced with 0603
    - All through hole capacitors replaced with 0603
    - through hole LEDs replaced with SMT
    - Added jumpers to switch between SPI and USART peripheral for LED
    controllers
    - USART in SPI master mode allows DMA.
    - Added reset button.
    - Added a pullup on AVR reset line.
    - Moved T1 and BUZZ (JST conn) further from screw holes.
    - Moved vibrator further from screw holes.
    - Replaced IR receivers with SMT heimdall package
    - Added a footprint for a 3rd IR receiver (facing up)
    - Replaced through hole NPN transistor with SMT
    - Replaced 4 pin ISP with 6 pin 50mil RA header.
    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
    [shoulder.brd, shoulder.sch]
2016-08-30 Moved filter caps and added test points
    [shoulder.brd, shoulder.sch]
2016-08-30 shoulder board: fix rev2 bugs
    - Bump board revision to rev3
    - Remove USART/SPI jumper - USART works fine
    - resolves GF-38
    - Fix ISP pin hole sizing
    - resolves GF-37
    [shoulder.brd, shoulder.sch]
2016-09-01 leds: split usart/spi drivers out from LED control.
    - common/led_spi.c: spi driver
    - common/led_usart_spi: USART in SPI master mode driver (with DMA
    option)
    - Each driver exposes an _init() function that returns an led_controller
    struct, which contains function pointers to the various operations.
    - LED code simply calls controller_dev->do_something(controller_dev,
    ...), not caring about which driver is in use.
2016-09-01 leds: split LED pattern/sequence definition into new header
2016-09-01 leds: move some function declarations out of header
2016-09-01 leds: rename led_controller to led_spi_dev
2016-09-02 leds: [part I] break TLC59711 driver out of LED pattern code
    - Instantiate a tlc59711_dev and pass in SPI driver.
    - functions to change tlc59711 settings/led colors
    - WAAAAY more sane.
    - Setting brightness is actually implemented correctly in the tlc59711
    driver; brightness control was wack (crazy wrong) before.
    - brightness control via the MPC command needs to be re-implemented
    still
    [leds.c, leds.h, tlc59711.c]
2016-09-03 leds: re-implement brightness adjustment
2016-11-30 mpc: register commands to a table
    - Bit of premature optimization to avoid the O(n) lookups.
    [mpc.c]
2016-12-11 Disable boot timer after all boards enumerate.
2016-12-13 Increase queue sizes. All of them. Probably.
    - I guess that "TODO: hard-coded queue size" was a bad idea.
    - This caused dropped packets when too many events came from the board.
    - All this crappy comm code needs to be cleaned up anyway.
2016-12-17 Take 2 at acceptance testing framework.
    - Still needs work
2016-12-21 Break UART driver out of serialcomm driver [comm rewrite: part 1]
    - Display broken (need to add SPI driver)
    - Why is the comm code so fucked? What was I thinking? Was I thinking?
    - more to come untangling this mess
    [display.c, mpc.c, serialcomm.c, serialcomm.h, uart.c, uart.h, xbee.c]
2016-12-23 Remove traces of comm from serialcomm tx [comm rewrite: part 3]
2016-12-24 Fully decouple xbee driver from old comm driver [comm rewrite: part 6]
2016-12-26 Rewrite SPI driver [comm rewrite: part 7]
2016-12-31 Decouple comm driver from mpctwi driver [comm rewrite: part 9]
    - Remove remaining traces of comm from everywhere!
2017-01-01 Implement comm changes on remaining boards [comm rewrite: part 10]
    - The final big part of the rewrite.
2017-01-02 Use freertos timers.
2017-01-03 Decouple MPC from MPC/HW drivers.
2017-01-06 Add hook in mpc_init to register drivers.
2017-01-07 Decouple LED transport (usart/spi) drivers from LED code.
2017-01-07 Remove redudant paramaters from led driver initialization.
    The port and pins are implied by the USART/SPI module: i.e. USARTC1 is
    always PORTC with pins 5, 6, 7. There's no need to pass this in the
    initialization.
2017-01-07 Hugely restructure include directories.
    - rename bsp/ to drivers/
    - mimic the drivers/ structure in include/
    - etc. yada.
2017-01-07 Move tlc59711 driver to drivers/
2017-01-07 Move TWI drivers to drivers/xmega
2017-01-07 fixup! Ensure allocated memory is pointer aligned.
    [malloc.c]
2017-01-07 Add unmodified cmake toolchain.
    From: https://github.com/swift-nav/libswiftnav/blob/master/cmake/Toolchain-gcc-arm-embedded.cmake
2017-01-07 fixup! Ensure allocated memory is pointer aligned.
    - Rather, maximally alligned.
    [malloc.c, mempool.h]
2017-01-08 fixup! Use port(ENTER|EXIT)_CRITICAL() instead of avr-gcc's ATOMIC_BLOCK().
    [mempool.c]
2017-01-08 Force inlining of certain functions to prevent linker errors.
    Of course, the assumption is that these can always be inlined.
    [mpc.h]
2017-01-08 Add a working LED blink test.
    - Link in startup code.
    - Set corresponding entry in LDFLAGS
    - Add LED blinker test in saml21.c
    - Add programming with edbg (via program target)
    - Dump raw binary with objcopy
    - Output size of ELF sections
2017-01-08 Modify LED blinker to exercise scheduler.
2017-01-08 Handle SysTick interrupt - scheduler working.
2017-01-08 Move xmega system timer configuration to port.c
2017-01-17 Barebones ugly working i2c slave driver.
2017-01-17 Partially working I2C master.
2017-01-17 Switch to correct linker script for actual part.
2017-01-20 Implement generic registration for SERCOM ISRs.
    - Remove hard-coded ISRs from TWI master/salve drivers
    - Add a static ISR table for SERCOMs that allows passing a void pointer
    into the ISR.
2017-01-20 Move TWI PinMux configuration out of TWI driver.
2017-01-20 Add a common TWI Master driver interface.
    - Break out common parts of SAML21 and XMEGA implementations into
    drivers/twi/master.
2017-01-20 Add a common twi slave driver interface.
    - The slave's only public method is _init, which is
    implementation-defined.
    - Make twi_slave_t an opaque type: the common header file has the
    typedef and a forward declaration of the struct; details are left to
    the individual drivers.
2017-01-21 Break ins, begin_txn, end_txn out of twi_slave_init
    These need to be set in more generic ways that is not device specific
    (the initializer *is* device specific).
2017-01-21 Break ins and txn_complete out of twi_master_init
    - Add separate function to set these values
    - _init is device-specific, but the txn_complete callback needs to be
    generic.
2017-01-21 xmega: Move TWI Master ISR Handling into TWI Master driver.
    - Rather than having the interrupt vector defined ... elsewhere, create
    static table of TWIM device instances so the ISR can be called
    directly from the driver.
2017-01-21 xmega: Move TWI Slave ISR handling into TWI Slave driver.
    - Rather than havning the interrupt vector defined ... elsewhere, create
    static table of TWIS device instances to they ISR can be called
    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
2017-01-21 Fix incorrect references to GCLK_ID_CORE
    wait... how did this work? I guess because the slave didn't need the
    clock??
    [slave.c]
2017-01-21 Break clock configuration out of TWI drivers.
    - Still needs work to make the configuration more generic, and probably
    to allow passing it into the driver initializers.
2017-01-22 saml21: implement LED controller SPI driver backend.
2017-01-25 saml21: initial implementation of DMA for LED controller
2017-01-25 Remove commented code that pertains to xplained board.
2017-01-26 xmega: update led_spi driver to account for removal of tx_isr.
2017-01-26 xmega: move xmega SPI driver into drivers/xmega/
2017-01-26 xmega: (shoulder) Remove MPC_*_ISR - TWI driver handles this now.
2017-01-26 xmega: Make master and slave drivers take TWI_t
    Rather than the TWI_SLAVE_t or TWI_MASTER_t - this allows consolidating
    the code to get the index number of the TWI module for use in the ISRs.
2017-01-26 xmega: Fix mis-spelled TWI vector names.
    [master.c, slave.c]
2017-01-26 Fix buffer overflow - initializing refcnt wrong
    [mempool.c]
2017-01-26 Add configuration for shoulder V1 hardware
    cmake ... -DSHOULDER_V1_HW=1 to build for V1 HW (this is dirty as fuck)
    - Swap R/B on four of the LEDs
    - Use SPI instead of USART in SPI mode for led controllers.
    ... shouldn't need this for long.
    [leds.c]
2017-01-27 xmega: Get build working for master board.
    Also, this code appears to actually work, at least basically. WTF???
2017-01-27 xmega: Make build work for chest board.
    ... And this actually seems to work???
2017-01-27 Shoulder rev4 hardware
    [shoulder.brd, shoulder.sch]
2017-01-28 Move common/uart.c to drivers/xmega/uart.c
2017-01-28 xmega: Move usart driver interrupt handling into driver.
2017-01-29 xmega: Move led_usart_dma_get_trigsrc to uart driver.
2017-01-29 xmega: Add a basic DMA driver.
    - Allocate DMA channels, automatically enabling the controller.
    - Set source and dest addrs.
2017-01-29 xmega: Split dma/interrupt initialization in led_usart_spi driver.
2017-01-29 xmega: Make uart driver more configurable.
2017-01-29 xmega: Make uart_dev_t an opaque type.
2017-01-29 xmega: Add interrupt handling to DMA driver.
2017-01-29 xmega: Add TX DMA to uart driver.
2017-01-29 xmega: Enable DMA for Phasor TX
2017-01-29 xmega: Fix DMA channel allocation -- only allocate 1 channel.
    [dma.c]
2017-08-12 twi: Fix a syntax error.
    DID I EVEN RUN THIS CODE???!?!?!?!
    ... Did I even compile this code? What code is running on the MCU
    now?!?!?!
    [master.c]
2017-11-17 leds: Change brightness command to use an absolute value.
    Rather than just up/down.
2017-11-22 charger: add ee files.
    [batt-charger.brd, batt-charger.sch]
2017-11-23 settings: Add API to distribute settings.
    - Remove command to set brightness. Replaced with setting.
    - Set default brightness in master/game.c
    Larger modifications to back/phasor because apparently I had made updates
    to other APIs without updating them. Back seems to work. Phasor is
    untested and trigger had large modifications, so probably not working.
    Oops.
    [charger.c, game.c, irtx.c, leds.c, main.c, settings.c]
2017-11-24 phaser: Use uart driver to register interrupt handler.
    This comes after stupidly adding a weak attribute to the driver's
    handlers fully not considering the fact that the default implementations
    (BADISR_vect) would then override them. :D oops.
2017-11-24 phaser: Use the usart driver to get usart port info.
2017-11-24 phaser: remove no longer necessary configuration
    [config.h]
2017-11-25 mpc: Slight hack to make sure board hello gets sent after other tasks.
    Just incase this happens too quickly and there are handlers that still
    need to be registered.
2018-01-20 sounds: fix initialization of flexible array members.
    [sounds.h]
2018-04-09 sercom: Support SAMD51 clocks and DMA trigger sources.
2018-04-09 sam: Change most "SAML21" references to "SAM"
    - drivers/saml21 all moved to drivers/sam.
    - ARM toolchain file split into toolchain file and SAM target file.
    - SAML21 definitions moved to saml21.cmake.
    - Will it build on SAMD51? I wonder...
2018-04-09 sam: Fix a dumb/nasty hack for registering ISRs.
    [isr.c]
2020-03-13 sam: begin updating drivers for SAMD
2020-03-13 sam: Change part from samd51p20a to samd51n20a
    I don't know why I had samd51p20a when I think the schematic always had
    samd51n20a.
2020-03-13 dma: Update DMA driver for SAMD51
2020-03-13 led: Update SPI driver for SAMD51
2020-03-13 master: add LEDs to master project.
    Since the master is now also the back board.
2020-03-13 sam: add function to set pin muxes
2020-03-13 master: Reset MCU when power is turned on.
    A strange turn of events given this already happens automatically when
    the switch is flipped off...
    [main.c]
2020-03-13 config: add GPIO pin assignments.
    I'll probably use these later.
2020-03-13 sam: Add more functions for setting pin configuration.
2020-03-13 mpc: Change registered drivers to a linked list.
2020-03-13 mpc: Make back/master the same address.
    - Add a loopback driver so it can talk to itself. In theory all the code
    just works TM
2020-03-13 master: Move board initialization to a task.
    More to follow.
    This got interesting when I discovered a board in my power MUX that
    allowed the MCU to power itself off.
2020-03-14 sercom: Unify interrupt handling; works on SAML21 and SAMD51
    (not that I have tested on SAML21, or with interrupt line 3...)
    SAML21 has one interrupt line per sercom; SAMD51 has four. The first
    four interrupt flags use dedicated lines while the remainder are
    multiplexed in the 4th. SAML21 multiplexes all of them in one handler.
    This moves all of the handling of those to the sercom driver.
2020-03-14 fixup! config: Change some FreeRTOS config to slightly more sane variables.
    [sercom.c, xbee.c]
2020-03-14 fixup! sercom: Unify interrupt handling; works on SAML21 and SAMD51
    [sercom.c]
2020-03-24 isr: fix vector table alignment.
    [isr.c]
2020-03-26 sdhc: First pass at using interrupts.
    Quick and dirty conversion from spinning to using interrupts. It works,
    so I'll save the questions for later.
2020-03-26 freertos: tweak config
    - Better interrupt priorities
    - preemption
    - mutexes
    - function to get current task handle
2020-03-26 mpcipc: Copy transmitted packets to avoid losing them.
    We lose custody of the buffer when the send function returns, thus a
    copy must be made.
    [mpcipc.c]
2020-03-26 main: initialize settings.
    - And do game last because it needs many other things (although strictly
    speaking this is problematic because some of the initialization is done
    in tasks)
    [main.c]
2020-03-26 game: Include master in the all boards list.
    This _is_ master, but it needs to talk to itself via IPC.
    Also remove the lights_booting() hack that was masking a real issue.
    [game.c]
2020-03-26 game: Reduce fake boot time.
    i.e. the time during which we enumerate boards and flash the lights in a
    certain pattern. Aint nobody got time for this.
